ETML-ES-SLO/PRJ_2225_VumetreFrequentiel/2225_B/doc/datasheets/50_Connectors/jack/CUI_DEVICES_SJ1-3533NG/BOM.txt

3DX_CUI_DEVICES_Supplier: CUI Devices
3DX_CUI_DEVICES_Description: 3.5 mm Right-Angle Stereo Jack, 3 Pin PCB Mount, Isolated Ground
3DX_CUI_DEVICES_Model Number: SJ1-3533NG
