ETML-ES-SLO/PRJ_2225_VumetreFrequentiel/2225_B/doc/liens utiles/liens utiles.docx

# USB-C

https://www.act-connectivity.com/fr-fr/usb-c-expliqu%C3%A9#:~:text=Power%20Delivery%20et%20l'USB,%2C%2012V%2C%2015V%20et%2020V.

https://fr.wikipedia.org/wiki/USB_Type-C#:~:text=Depuis%202021%2C%20la%20sp%C3%A9cification%20USB,des%20broches%20CC%20reste%20disponible.

USB-C - Wikipedia (https://en.wikipedia.org/wiki/USB-C)
