ETML-ES-SLO/PRJ_2225_VumetreFrequentiel/2225_B/doc/recherche composant/recherche composants.docx

# Alimentation découplage 5V-3V3

173950336 Würth Elektronik | Alimentations à montage sur carte | DigiKey (https://www.digikey.ch/fr/products/detail/w%C3%BCrth-elektronik/173950336/10468276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)
