ETML-ES-SLO/PRJ_2225_VumetreFrequentiel/2225_B/doc/documents rendu/2225B_VumetreFrequentiel_Code_Gest_LED_C.pdf

/* ************************************************************************** */ /** Descriptive File Name

@Company
Company Name

@File Name
filename.c

@Summary
Brief description of the file.

@Description
Describe the purpose of this file.
*/
/* ************************************************************************** */

/* ************************************************************************** */ /* ************************************************************************** */
/* Section: Included Files | */
/* ************************************************************************** */ /* ************************************************************************** */

/* This section lists the other files that are included in this file.
*/

/* TODO: Include other files here if needed. */
#include <stddef.h> | // Defines NULL

#include <stdbool.h> | // Defines true

#include <stdlib.h> | // Defines EXIT_FAILURE

#include "app.h"

#include "Gest_LED.h"

/* ************************************************************************** */ /* ************************************************************************** */
/* Section: File Scope or Global Data | */
/* ************************************************************************** */ /* ************************************************************************** */

/* A brief description of a section can be given directly below the section banner.
*/

//fonction :Gest_LED
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
void All_LED_Off (void)

11.1 of 13 | 2024.09.24 08:22:50

LED0_ROff();
LED0_GOff();
LED0_YOff();

LED1_ROff();
LED1_GOff();
LED1_YOff();

LED2_ROff();
LED2_GOff();
LED2_YOff();

LED3_ROff();
LED3_GOff();
LED3_YOff();

LED4_ROff();
LED4_GOff();
LED4_YOff();

LED5_ROff();
LED5_GOff();
LED5_YOff();

LED6_ROff();
LED6_GOff();
LED6_YOff();

LED7_ROff();
LED7_GOff();
LED7_YOff();

LED8_ROff();
LED8_GOff();
LED8_YOff();

LED9_ROff();
LED9_GOff();
LED9_YOff();
}
/* ************************************************************************** */ /* ************************************************************************** */
// Section: Interface Functions | */
/* ************************************************************************** */ /* ************************************************************************** */

/* A brief description of a section can be given directly below the section banner.
*/

// *****************************************************************************

12.1 of 13 | 2024.09.24 08:22:50

/**
@Function
int ExampleInterfaceFunctionName ( int param1, int param2 )

@Summary
Brief one-line description of the function.

@Remarks
Refer to the example_file.h interface header for function usage details. */
int ExampleInterfaceFunction(int param1, int param2) {
return 0;
}

/* ***************************************************************************** End of File
*/
13.1 of 13 | 2024.09.24 08:22:50
