ETML-ES-SLO/PRJ_2225_VumetreFrequentiel/2225_B/doc/documents rendu/2225B_VumetreFrequentiel_Code_dac_ad5620_h.pdf

#ifndef dac_ad5620_H

#define dac_ad5620_H

/*--------------------------------------------------------*/ // dac_ad5620_H.h
/*--------------------------------------------------------*/ //Description :Utiilisation DAC AD5620
//
//Auteur : LDD
//Version:V1.0
//Compilateur:XC32 V2.50
//
/*--------------------------------------------------------*/

#include <stdint.h>

// prototypes des fonctions void Dac_Init(void);
void Dac_Write( uint16_t ech); void spi_write( uint8_t Val);

#endif // dac_ad5620_H

C:/microchip/harmony/v2_06/apps/2225_VumetreFrequenciel/firmware/src/dac_ad5620.h

1.1 of 1 | 2023.06.19 14:35:32
