ETML-ES-SLO/PRJ_2225_VumetreFrequentiel/2225_B/doc/datasheets/40_LEDs/Résutat led.PNG

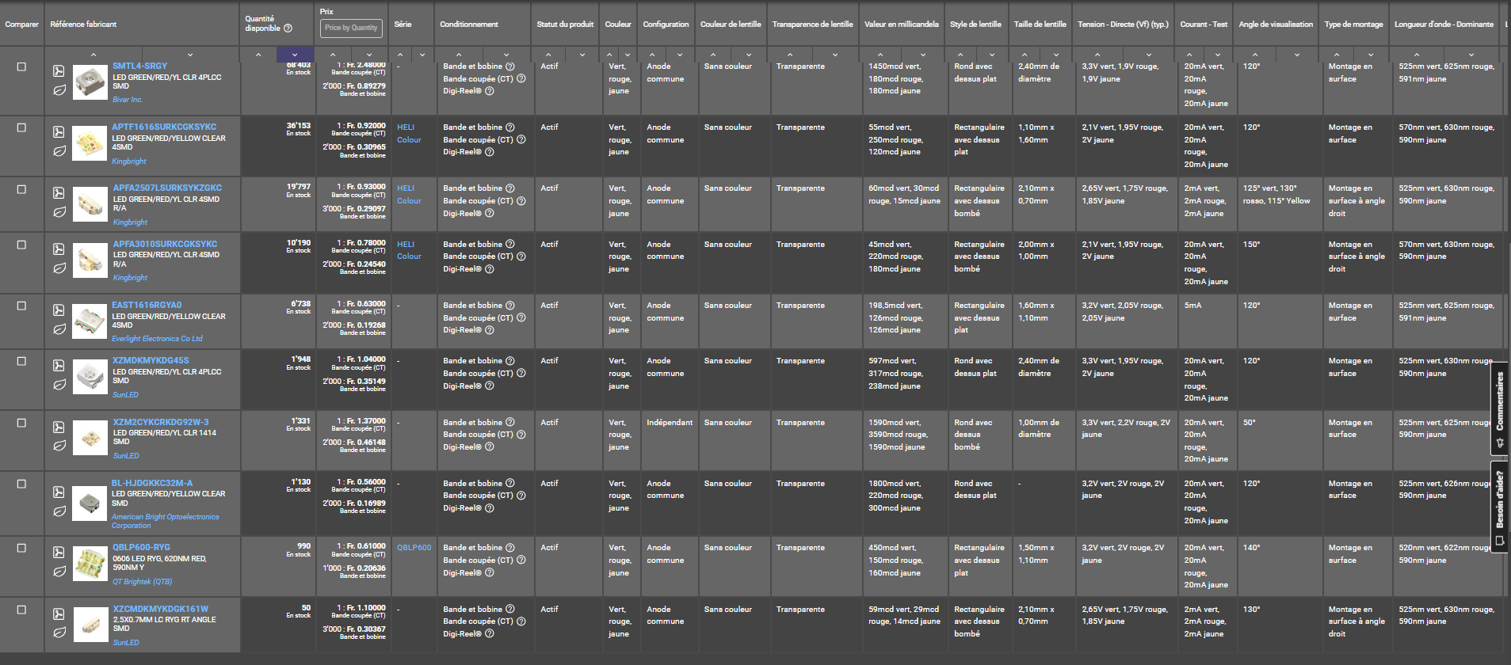
2225_B/doc/datasheets/40_LEDs/Résutat led.PNG
