ETML-ES-SLO/PRJ_2225_VumetreFrequentiel/2225_B/doc/immages rapport/173950336.jpg

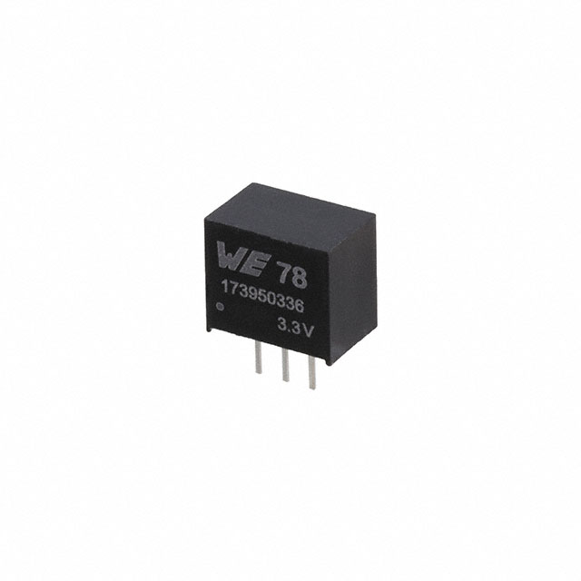
2225_B/doc/immages rapport/173950336.jpg
