ETML-ES-SLO/PRJ_2225_VumetreFrequentiel/2225_B/doc/screeen/adc config armony 2.PNG

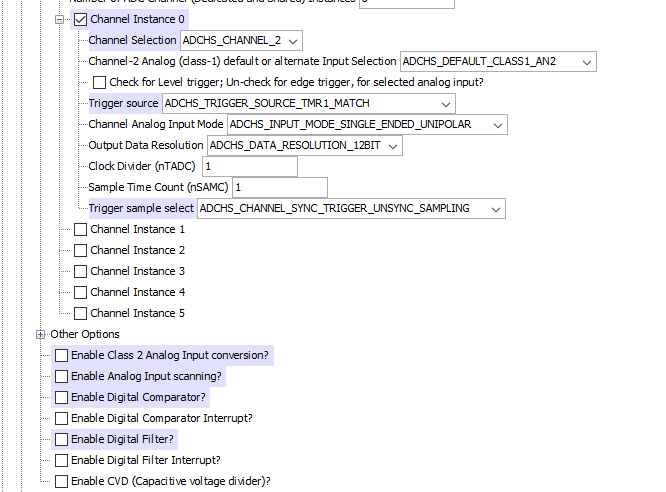
2225_B/doc/screeen/adc config armony 2.PNG
