ETML-ES-SLO/PRJ_2225_VumetreFrequentiel/2225_B/doc/screeen/CH1usbCH1usbCH3RXD FTDI.BMP

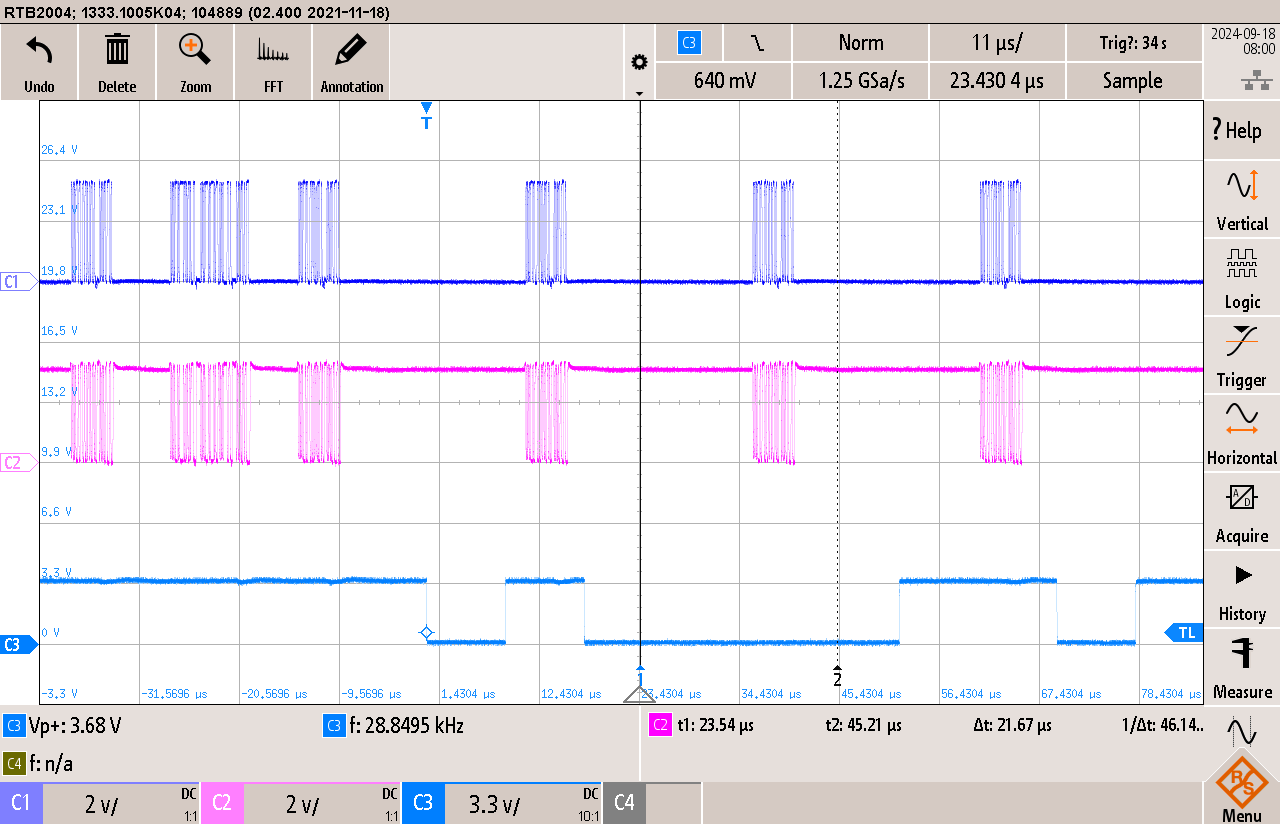
2225_B/doc/screeen/CH1usbCH1usbCH3RXD FTDI.BMP
