ETML-ES-SLO/PRJ_2225_VumetreFrequentiel/2225_B/doc/screeen/fréquence pour timers.PNG

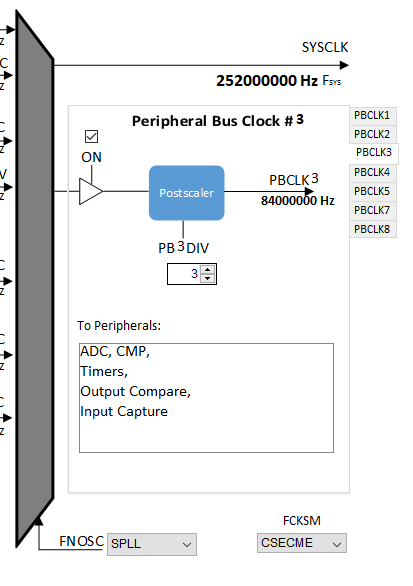
2225_B/doc/screeen/fréquence pour timers.PNG
