ETML-ES-SLO/PRJ_2225_VumetreFrequentiel/2225_B/doc/screeen/FTDI whith uc.PNG

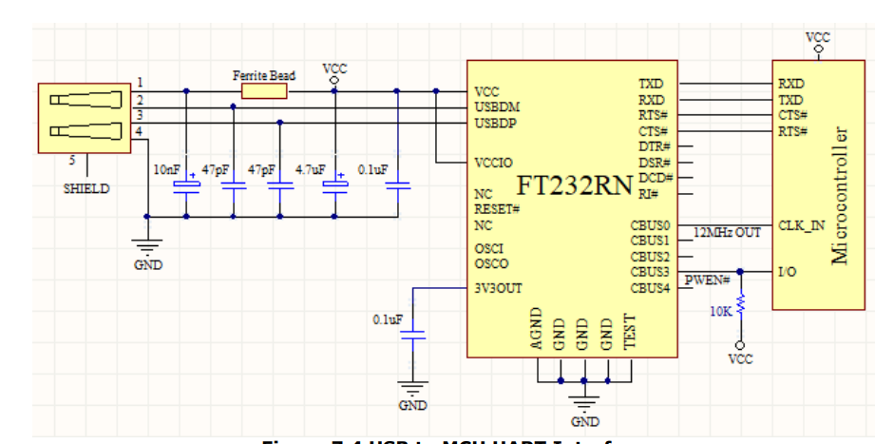
2225_B/doc/screeen/FTDI whith uc.PNG
