ETML-ES-SLO/PRJ_2225_VumetreFrequentiel/2225_B/doc/screeen/MESURE_DAC1V.BMP

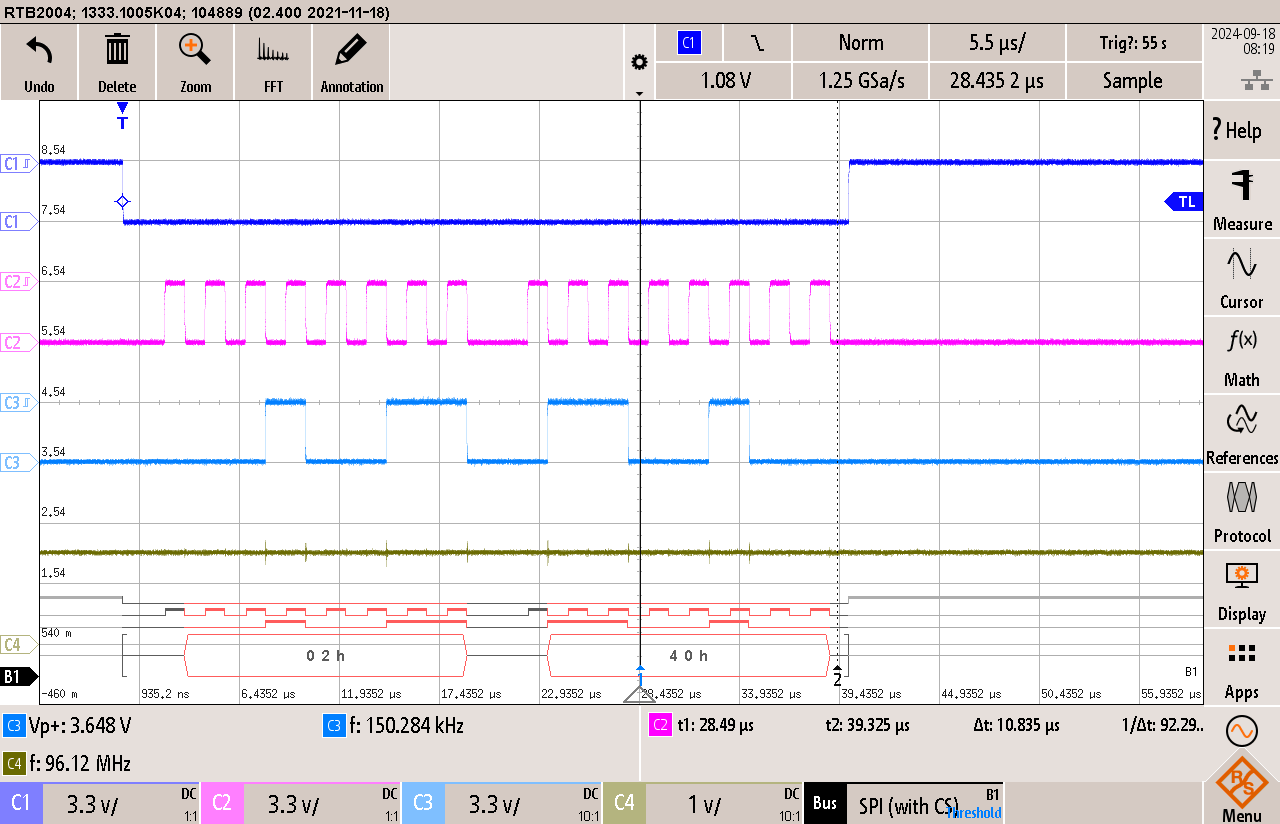
2225_B/doc/screeen/MESURE_DAC1V.BMP
