ETML-ES-SLO/PRJ_2225_VumetreFrequentiel/2225_B/doc/screeen/timer init armony.PNG

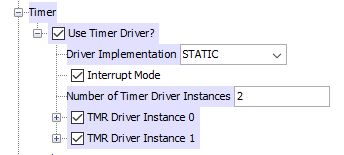
2225_B/doc/screeen/timer init armony.PNG
