ETML-ES-SLO/PRJ_2225_VumetreFrequentiel/2225_A/hard/BOM.xlsx

Désignation | Type | Nom | Lien internet | Quantité | Prix | Possédé?
 | Ampli-OP | MCP6002T-I/SN | https://www.digikey.ch/fr/products/detail/microchip-technology/MCP6002T-I-SN/500878 | 1 | 0.4 |  | Nombre composants | 17
 | Connecteur Jack 3.5mm | SJ-3523-SMT-TR | https://www.digikey.ch/fr/products/detail/cui-devices/SJ-3523-SMT-TR/281297 | 2 | 0.94 |  | Total: | 35.85
 | Connecteur Jack 6.35mm | SN37A12A | https://www.digikey.ch/fr/products/detail/switchcraft-inc/SN37A12A/1288899 | 2 | 3.63
 | Connecteur BNC | CONBNC002 | https://www.digikey.ch/fr/products/detail/linx-technologies-inc/CONBNC002/16013841 | 2 | 2.87
 | Connecteur programmation | 76384-406LF | https://www.digikey.ch/fr/products/detail/amphenol-cs-fci/76384-406LF/1001635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 | 1 | 0.82 | X
 | Connecteur alimentation | RASM722PTR13X |  | 1 | 2.31 | X
 | Quartz 10MHz | ATS100SM-1 | https://www.digikey.ch/fr/products/detail/cts-frequency-controls/ATS100SM-1/280226 | 1 | 0.34
 | Bouton poussoir | 430182043816 | https://www.digikey.ch/fr/products/detail/w%C3%BCrth-elektronik/430182043816/5209017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 | 1 | 0.49 | X
 | Regulateur 5V-3V3 | MAX1793EUE33+ | https://www.digikey.ch/fr/products/detail/analog-devices-inc-maxim-integrated/MAX1793EUE33/1513120 | 1 | 4.06 | X
 | Led témoin alimentation | LTST-C191KFKT | https://www.digikey.ch/fr/products/detail/liteon/LTST-C191KFKT/386833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 | 2 | 0.22 | X
 | Connecteur matrice à Leds | 61030821821 | https://www.digikey.ch/fr/products/detail/w%C3%BCrth-elektronik/61030821821/9857504 | 1 | 1.68
 | Microcontrôleur | PIC32MX470F512H-120/PT | https://www.digikey.ch/fr/products/detail/microchip-technology/PIC32MX470F512H-120-PT/5305173 | 1 | 9.83 | X
 | Référence de tension | TL431LIBQDBZRQ1 | https://www.digikey.ch/fr/products/detail/texas-instruments/TL431LIBQDBZRQ1/11308815 | 1 | 0.6
