ETML-ES-SLO/PRJ_2225_VumetreFrequentiel/2225_B/doc/estimation des couts/Estimation des couts.xlsx

Exstimation prix composants interne
Composant | quantité | prix unité [CHF] | Prix (aproximatif) [CHF]
régulateurs | 3 | 5 | 15
Module Xbee | 2 | 20 | 40
micro | 2 | 5 | 10
PCB | 2 | 60 | 120
Composants divers | 20 | 1 | 20
TOTAL |  |  | 205
