ETML-ES-SLO/PRJ_2225_VumetreFrequentiel/2225_A/hard/Footprints et symboles/IC_Microchip_PIC32MX470F512H-120_PT/parts/IC_Microchip_PIC32MX470F512H-120-PT_eec.STEP

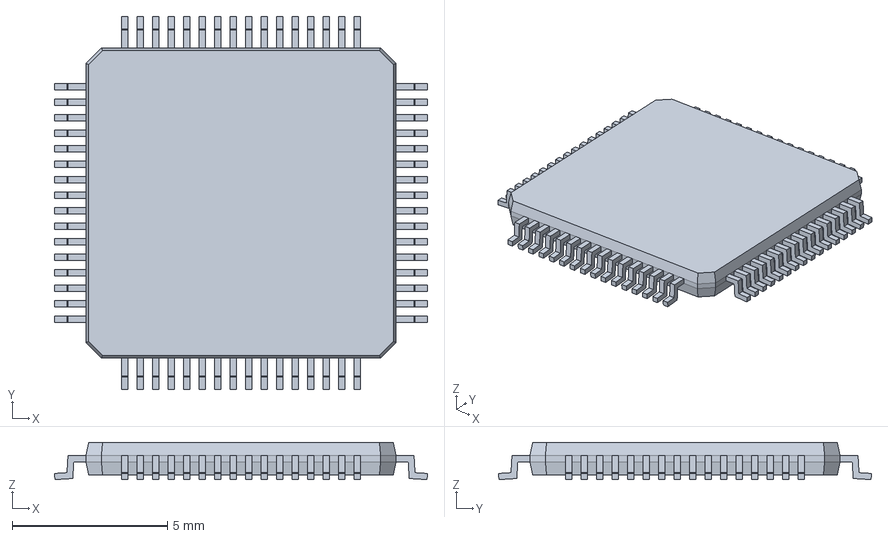
[picture p94: CAD file, 2024-09-24]
2225_A/hard/Footprints et symboles/IC_Microchip_PIC32MX470F512H-120_PT/parts/IC_Microchip_PIC32MX470F512H-120-PT_eec.STEP
12.0 x 12.0 x 1.20 mm
