ETML-ES-SLO/PRJ_2225_VumetreFrequentiel/2225_A/hard/Footprints et symboles/ul_MAX1793EUE33-/AltiumDesigner/2023-01-25_09-02-42/21-0108_U16E+3_MXM.step

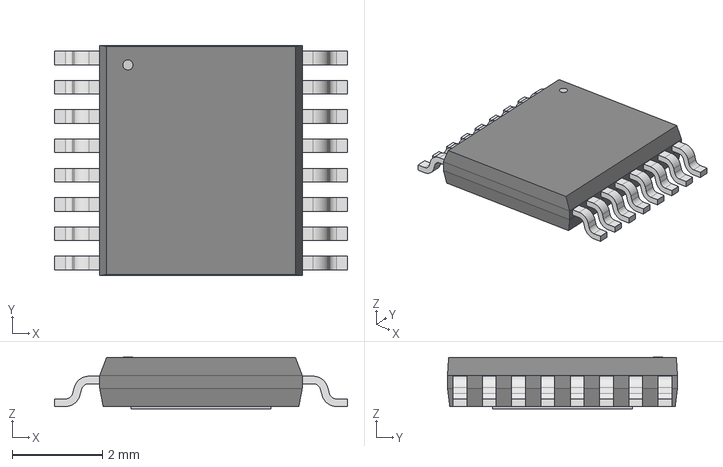
[picture p95: CAD file, 2024-09-24]
2225_A/hard/Footprints et symboles/ul_MAX1793EUE33-/AltiumDesigner/2023-01-25_09-02-42/21-0108_U16E+3_MXM.step
6.50 x 5.11 x 1.15 mm
