ETML-ES-SLO/PRJ_2225_VumetreFrequentiel/2225_A/hard/Footprints et symboles/ul_MCP6002T-I-SN/AltiumDesigner/2023-01-11_14-45-16/SOIC8-N_MC_MCH.step

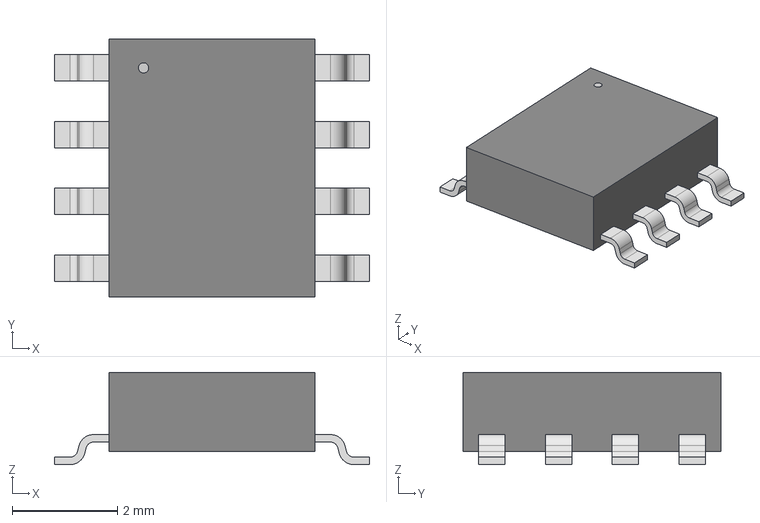
[picture p96: CAD file, 2024-09-24]
2225_A/hard/Footprints et symboles/ul_MCP6002T-I-SN/AltiumDesigner/2023-01-11_14-45-16/SOIC8-N_MC_MCH.step
5.99 x 4.90 x 1.75 mm
