ETML-ES-SLO/PRJ_2225_VumetreFrequentiel/2225_B/doc/datasheets/01_uc/PIC32MZ2048EFH064-250I_PT.STEP

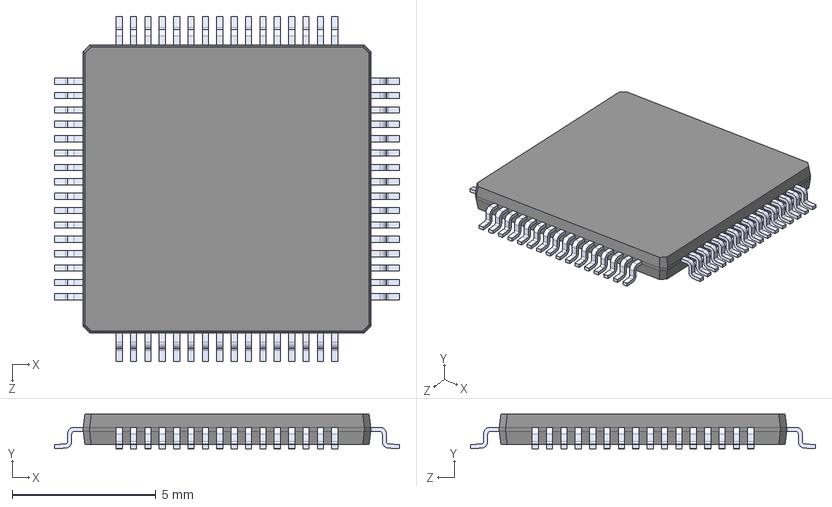
[picture p97: CAD file, 2024-09-24]
2225_B/doc/datasheets/01_uc/PIC32MZ2048EFH064-250I_PT.STEP
12.0 x 1.20 x 12.0 mm
