ETML-ES-SLO/PRJ_2225_VumetreFrequentiel/2225_B/doc/datasheets/10_dc-dc converter/STP_173950336_rev1.stp

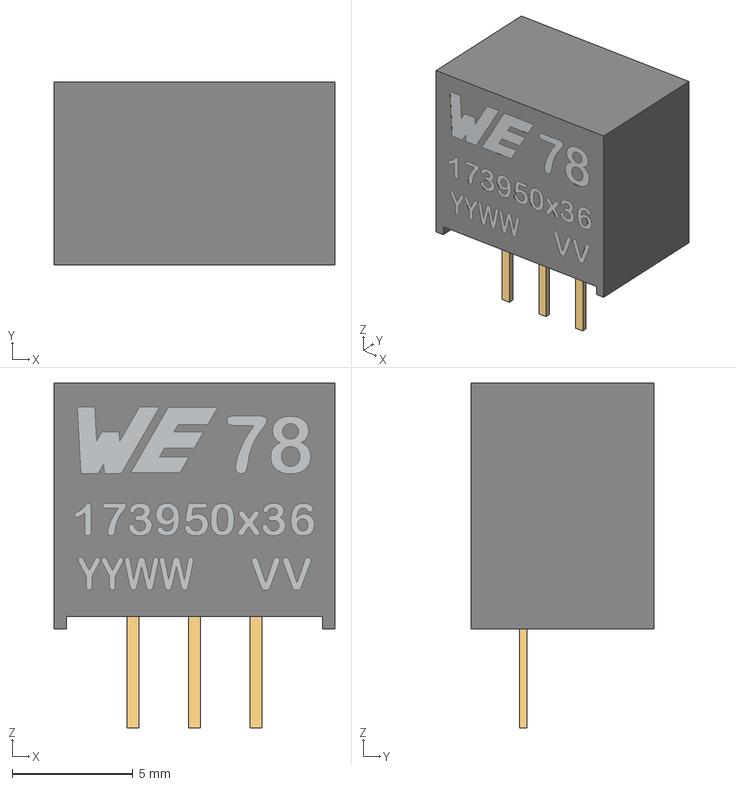
[picture p98: CAD file, 2024-09-24]
2225_B/doc/datasheets/10_dc-dc converter/STP_173950336_rev1.stp
11.6 x 7.55 x 14.3 mm
