ETML-ES-SLO/PRJ_2225_VumetreFrequentiel/2225_B/doc/datasheets/40_LEDs/LIB_APTF1616SURKCGKSYKC/APTF1616SURKCGKSYKC/3D/APTF1616SURKCGKSYKC.stp

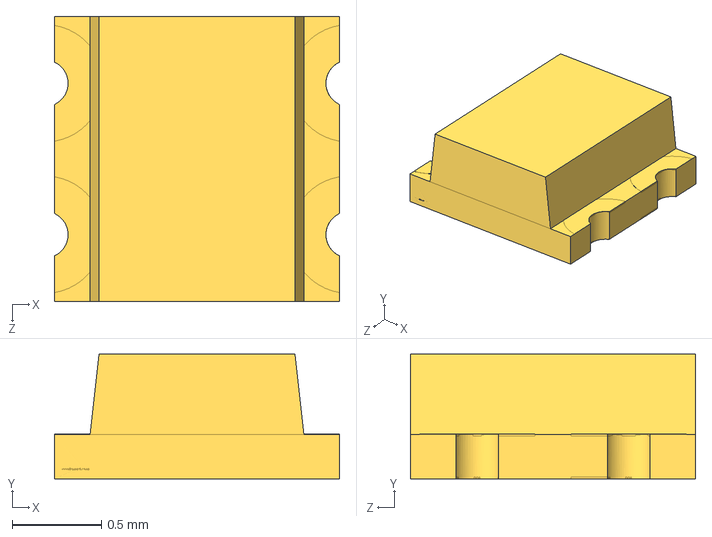
[picture p99: CAD file, 2024-09-24]
2225_B/doc/datasheets/40_LEDs/LIB_APTF1616SURKCGKSYKC/APTF1616SURKCGKSYKC/3D/APTF1616SURKCGKSYKC.stp
1.60 x 0.7 x 1.60 mm
