ETML-ES-SLO/PRJ_2225_VumetreFrequentiel/2225_B/doc/datasheets/41_Cap_Pol/4.7u/10SVP4R7M/4 SIZE CODE A5.stp

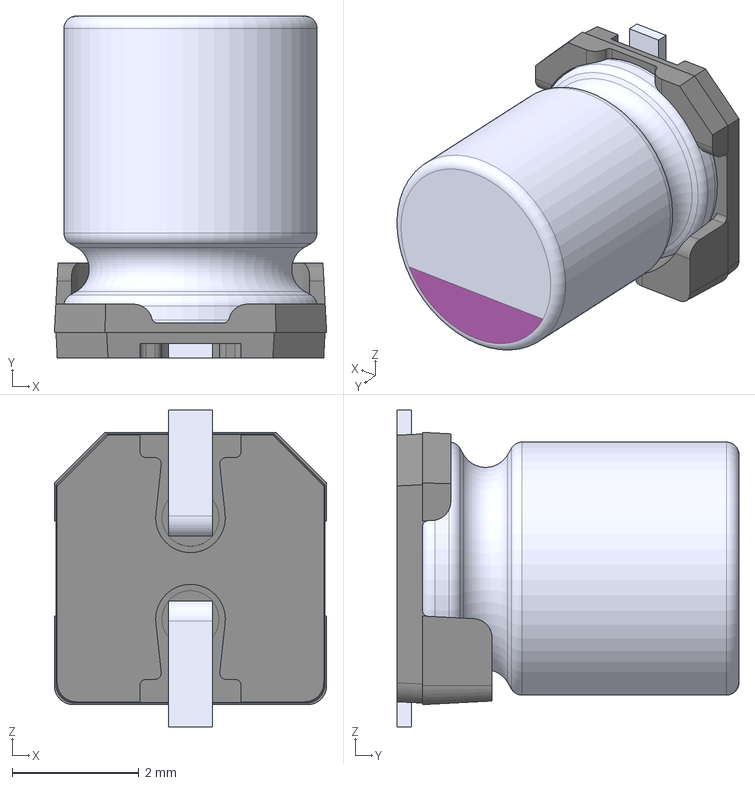
[picture p100: CAD file, 2024-09-24]
2225_B/doc/datasheets/41_Cap_Pol/4.7u/10SVP4R7M/4 SIZE CODE A5.stp
4.30 x 5.40 x 5.00 mm
