ETML-ES-SLO/PRJ_2225_VumetreFrequentiel/2225_B/doc/datasheets/41_Cap_Pol/4.7u/10SVP4R7M/AltiumDesigner/PCAP_SVP_A5_PAN.step

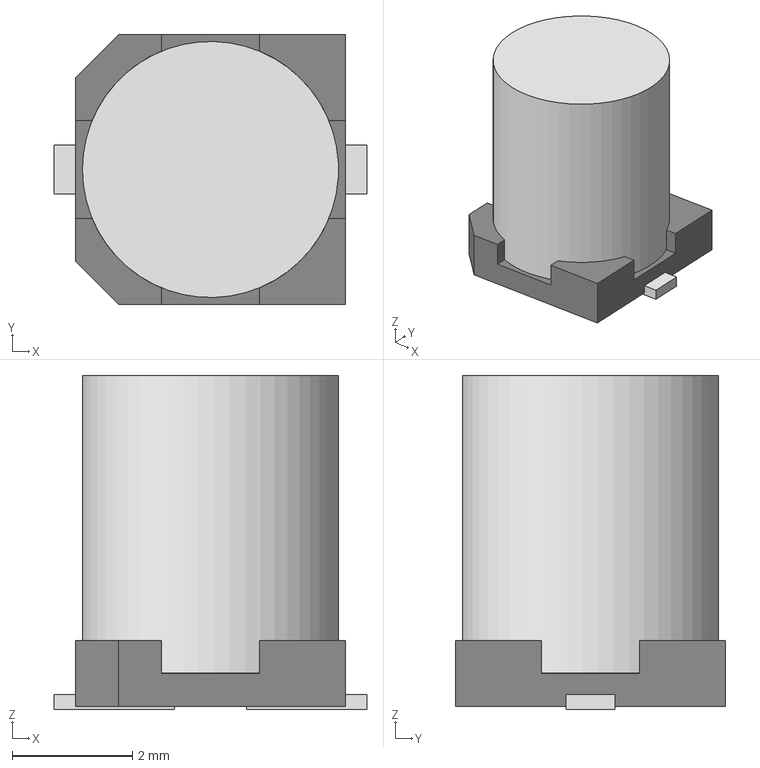
[picture p101: CAD file, 2024-09-24]
2225_B/doc/datasheets/41_Cap_Pol/4.7u/10SVP4R7M/AltiumDesigner/PCAP_SVP_A5_PAN.step
5.21 x 4.50 x 5.57 mm
