ETML-ES-SLO/PRJ_2225_VumetreFrequentiel/2225_B/doc/datasheets/50_Connectors/jack/CUI_DEVICES_SJ1-3533NG/CUI_DEVICES_SJ1-3533NG.step

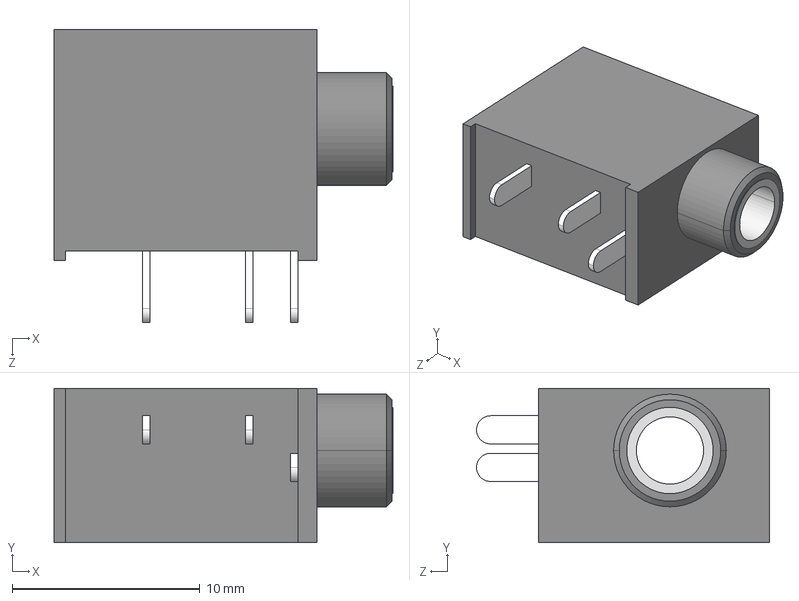
[picture p102: CAD file, 2024-09-24]
2225_B/doc/datasheets/50_Connectors/jack/CUI_DEVICES_SJ1-3533NG/CUI_DEVICES_SJ1-3533NG.step
18.1 x 8.20 x 15.6 mm
