ETML-ES-SLO/PRJ_2225_VumetreFrequentiel/2225_B/doc/datasheets/50_Connectors/USB-C/USB4085-GF-A--3DModel-STEP-56544.STEP

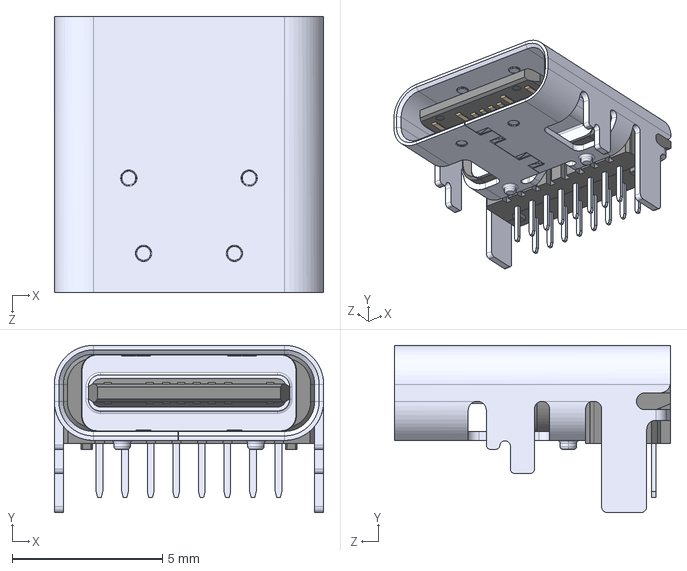
[picture p103: CAD file, 2024-09-24]
2225_B/doc/datasheets/50_Connectors/USB-C/USB4085-GF-A--3DModel-STEP-56544.STEP
8.95 x 5.56 x 9.17 mm
