ETML-ES-SLO/PRJ_2225_VumetreFrequentiel/2225_B/doc/datasheets/50_Connectors/USB-COM/USB-A1HSW6--3DModel-STEP-56544.STEP

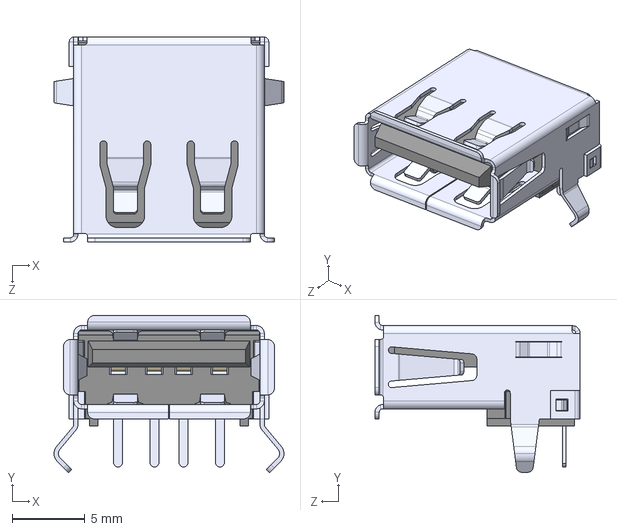
[picture p104: CAD file, 2024-09-24]
2225_B/doc/datasheets/50_Connectors/USB-COM/USB-A1HSW6--3DModel-STEP-56544.STEP
15.8 x 10.8 x 14.1 mm
