ETML-ES-SLO/PRJ_2225_VumetreFrequentiel/2225_B/doc/datasheets/60_FTDI/LIB_FT232RNL-REEL/FT232RNL-REEL/3D/FT232RNL-REEL.stp

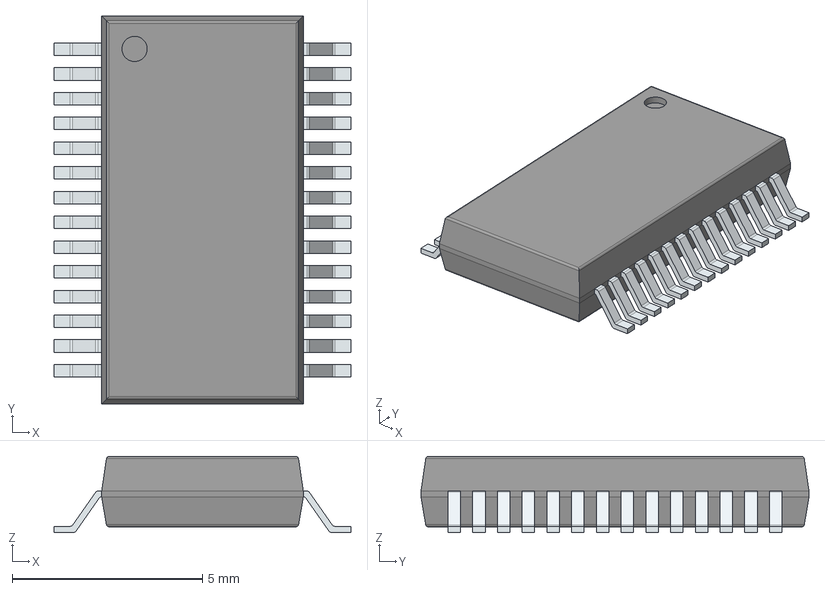
[picture p105: CAD file, 2024-09-24]
2225_B/doc/datasheets/60_FTDI/LIB_FT232RNL-REEL/FT232RNL-REEL/3D/FT232RNL-REEL.stp
7.80 x 10.2 x 2.00 mm
PinsArrayLR
