ETML-ES-SLO/PRJ_2225_VumetreFrequentiel/2225_B/doc/datasheets/90_IO_Expender/LIB_TCA9536DGKR/TCA9536DGKR/3D/TCA9536DGKR.stp

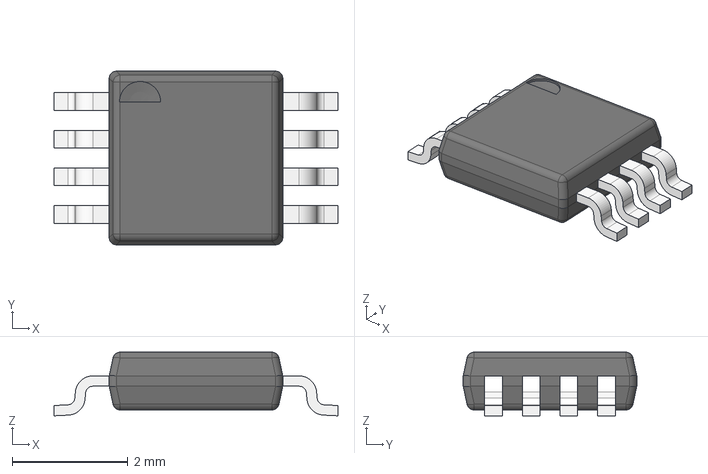
[picture p106: CAD file, 2024-09-24]
2225_B/doc/datasheets/90_IO_Expender/LIB_TCA9536DGKR/TCA9536DGKR/3D/TCA9536DGKR.stp
4.90 x 3.00 x 1.10 mm
BODY_MUA08A
LEAD_MUA08A x 8
