ETML-ES-SLO/PRJ_2225_VumetreFrequentiel/2225_B/doc/datasheets/50_Connectors/port_prog/61300611121_Download_STP_61300611121_rev1.stp

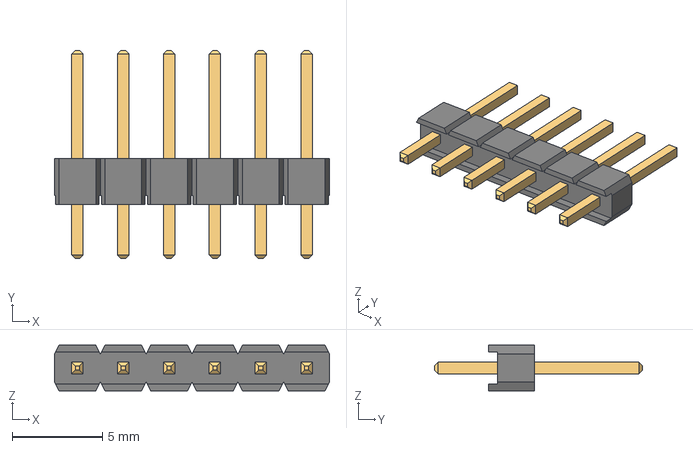
[picture p107: CAD file, 2024-09-24]
2225_B/doc/datasheets/50_Connectors/port_prog/61300611121_Download_STP_61300611121_rev1.stp
15.2 x 11.5 x 2.54 mm
6130xx11121_PIN x 6
