ETML-ES-SLO/PRJ_2225_VumetreFrequentiel/(list of files, cad)

Other CAD files:
2225_B/doc/datasheets/90_IO_Expender/LIB_TCA9536DGKR/TCA9536DGKR/Allegro/sop65p490x110-8n.psm
2225_B/doc/datasheets/90_IO_Expender/LIB_TCA9536DGKR/TCA9536DGKR/DEHDL/tca9536dgkr/chips/chips.prt
