ETML-ES-SLO/PRJ_2225_VumetreFrequentiel/2225_B/doc/planification + journal de travail/Planification.xlsx

Sheet: planification
No Jour travail |  | 1 | 2 | 3 | 4 | 5 | 6 | 7 | 8 | 9 | 10 | 11 | 12 | 13 | 14 | 15 | 16 | 17 | 18 | 19 | 20 | 21 | 22 | 23 | 24 | 25
Date |  | 2024-08-19 | 2024-08-20 | 2024-08-21 | 2024-08-22 | 2024-08-23 | 2024-08-26 | 2024-08-27 | 2024-08-28 | 2024-08-29 | 2024-08-30 | 2024-09-02 | 2024-09-03 | 2024-09-04 | 2024-09-05 | 2024-09-06 | 2024-09-09 | 2024-09-10 | 2024-09-11 | 2024-09-12 | 2024-09-13 | 2024-09-17 | 2024-09-18 | 2024-09-19 | 2024-09-20 | 2024-09-23
Tâches
lecture cahier des charge et premier et premier schéma block | théorique
 | rééle
étude et choix composants | théorique
 | rééle
réalisation du schéma | théorique
 | rééle
rechercher et réalisation footprints | théorique
 | rééle
réalisation du design | théorique
 | rééle
Programmation | théorique
 | rééle
Montage carte | théorique
 | rééle
test et validation différents modules | théorique
 | rééle
réalisation du code finale | théorique
 | rééle
Réalisation du programme C# | théorique
 | rééle
rédaction du rapport | théorique
 | rééle
Boîtier impémentation | théorique
 | rééle

Sheet: Journal de travail
Date | Tâches effectuées | Difficultés | solutions et décisions
2024-08-19 | prise connaisance du cahier des charges et compréhension de ce qui est demandé
2024-08-20 | compréhesion des principes de base et début de la recherche des composants
2024-08-21 | commencement du schéma
2024-08-22 | dimentionnement schéma + revue schéma
2024-08-23 | correction du schéma
2024-08-26 | recherche footprints
2024-08-27 | validation des footprints + placement des composants
2024-08-28 | finition du placement des composants + routage | taille du boîtier semble trop grande | pas de boîtier asser long avec une plus petite largeur
2024-08-29 | routage + BOM + revue PCB
2024-08-30 | Correction du PCB + Commande composants
2024-09-02 | Commande PCB | Probleme avec eurocircuit | correction effectuées plusieurs fois
2024-09-03 | Reflexion programme sur les filtres numériques
2024-09-04
2024-09-05 | Vérifiaction commande composants
2024-09-06 | Montage PCB
2024-09-09 | Finition montage PCB + test diffétents module
2024-09-10 | Test LEDS | 4 LEDs ne fontionne pas | refaire brasure LED + mosfet -> plus que 1 LED qui ne fonctionne pas
2024-09-11 | test ADC et DAC | Lecture ADC compliquée | Réussi a faire fonctionner l'ADC
2024-09-12 | recherche librairie filtres numérique | programme principale est ralenti à cause du DAC | faire le filtrage dans l'intéruption du timer
2024-09-13 | Programmation partie lecture échantillonage
2024-09-16 | Prgrammation partie prendre val haut et bas
2024-09-17 | Programmation de la partie offset | Offset incorect | Prbléme lors de la mesure du niveau haut et bas
2024-09-18 | Restructuration du programme | échantillons et calcul en meme temps | le programme doit attendre de faire un certains nombre d'échantillons avant de faire les calculs
2024-09-19 | faire au maximum pour avoir un programme qui aie au moins une lecture de fréquence
2024-09-20 | Rédaction rapport + mesures néscéssaires
2024-09-23 | rédaction du rapport
2024-09-24 | Rendu du rapport 10h00
2024-09-25
2024-09-26
2024-09-27
