ETML-ES-SLO/PRJ_2225_VumetreFrequentiel/2225_B/doc/documents rendu/2225B_VumetreFrequentiel_Schematic_Variant_No Variations.PDF

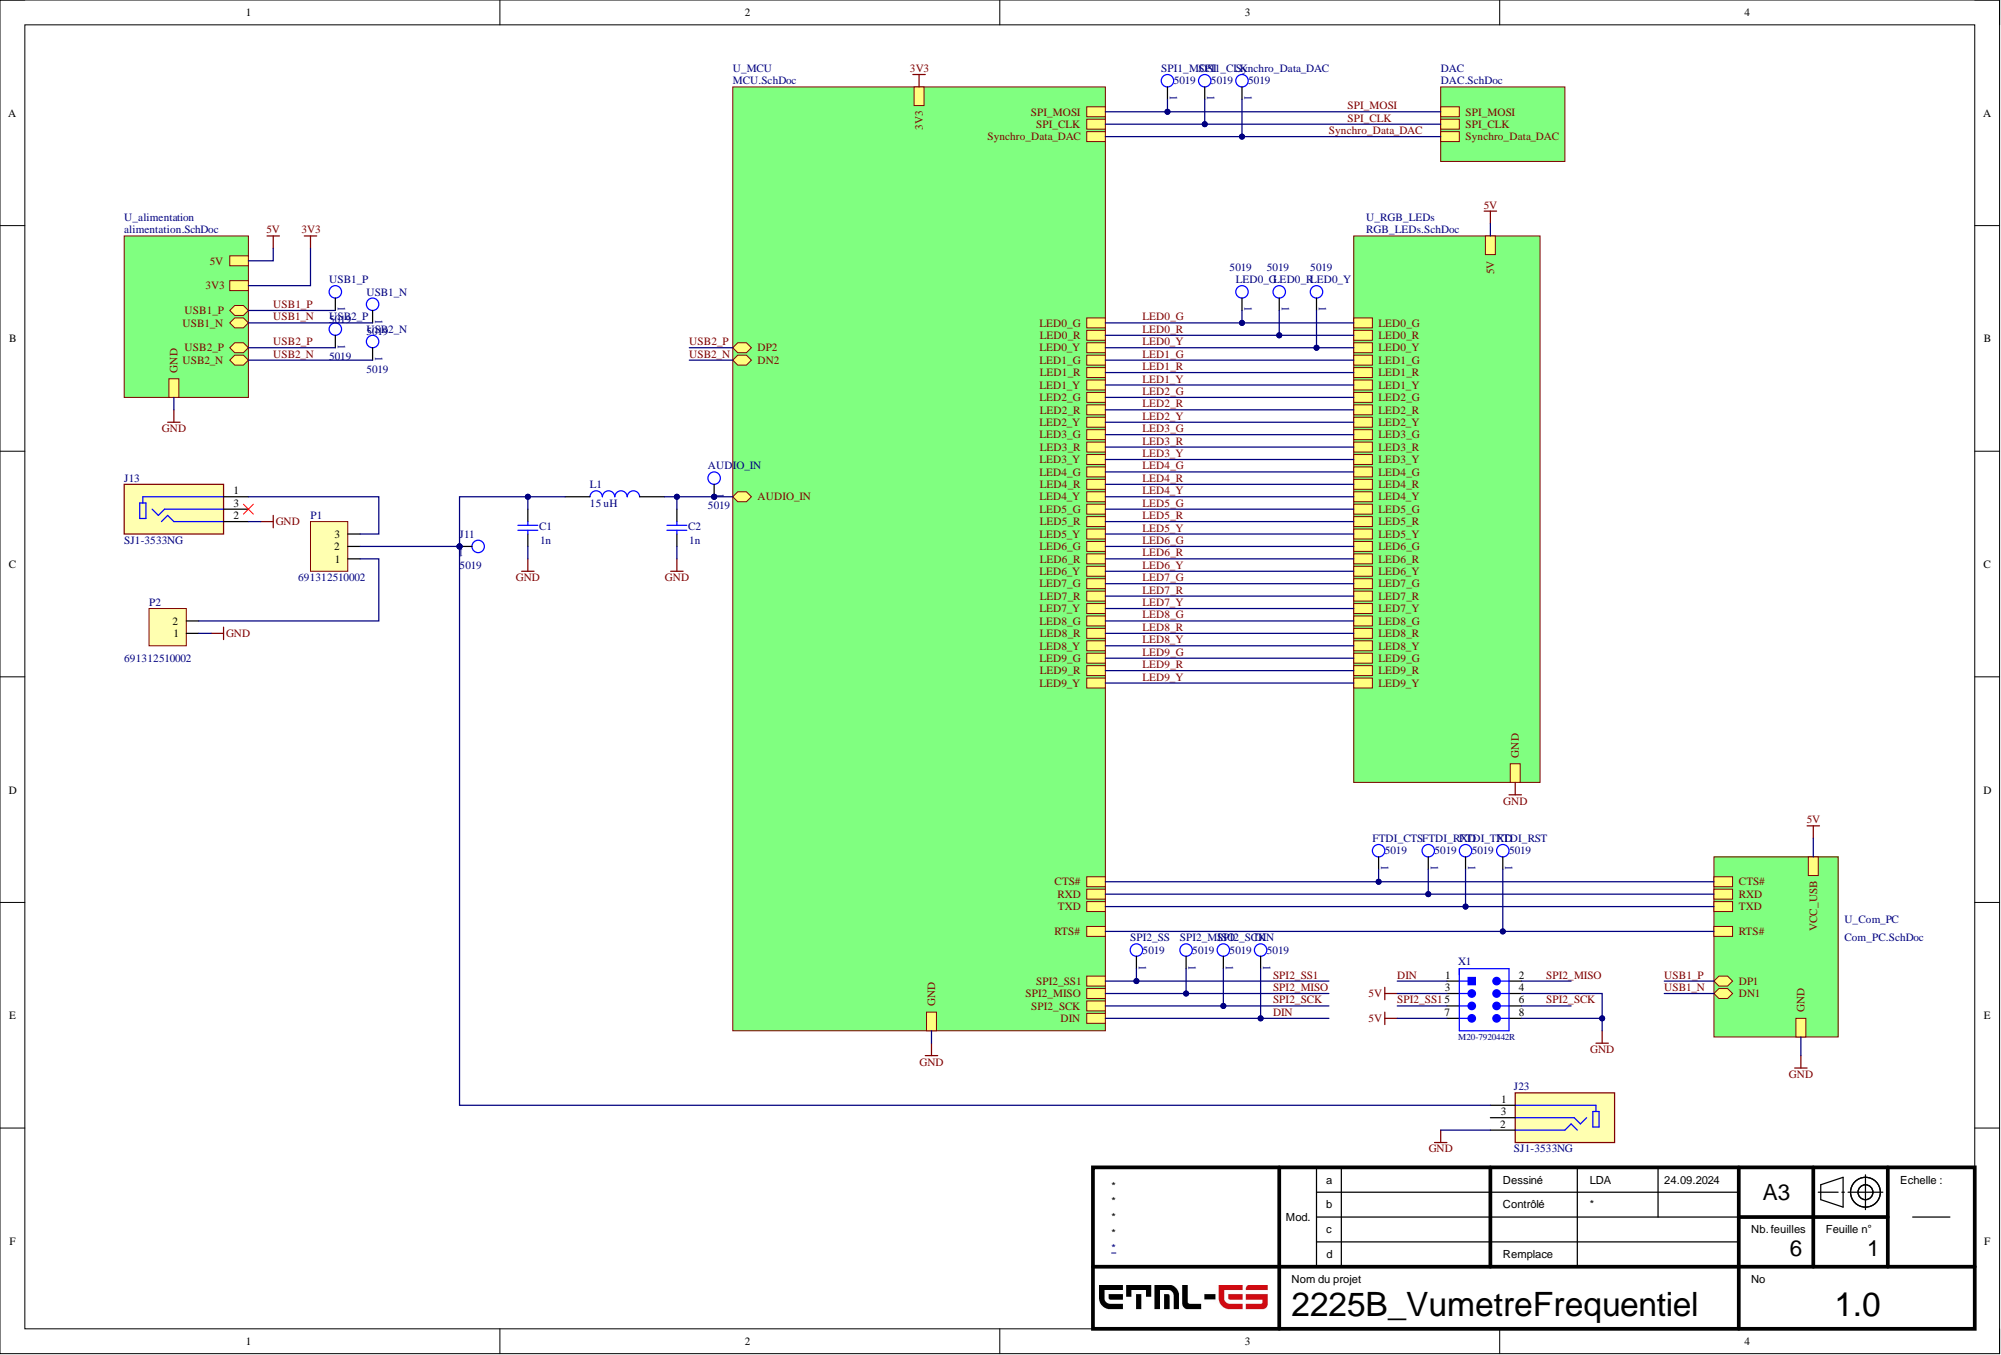
[picture p108: page 1]

SPI_CLK
Synchro_Data_DAC

* * * * * | Mod. | a | Dessiné | LDA | 24.09.2024 | A3 | | Echelle :

b | Contrôlé | *

c | | | | Nb. feuilles 6 | Feuille n° 1

d | Remplace

Nom du projet 2225B_VumetreFrequentiel | | | | | No 1.0

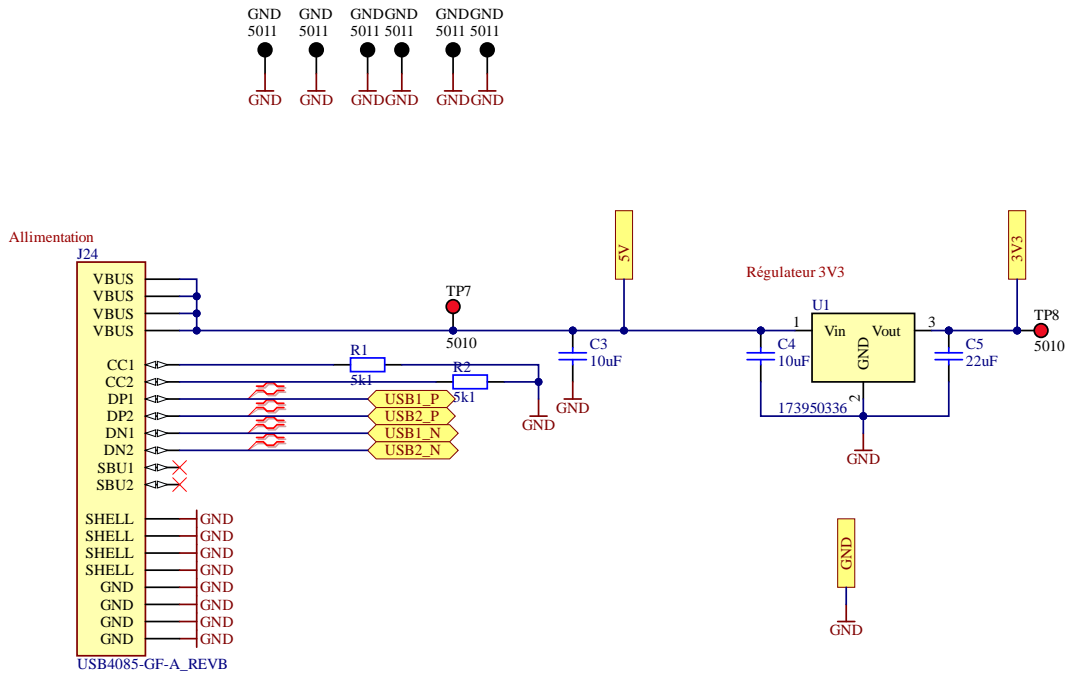
[picture p109: page 2]

* * * * * | Mod. | a | Dessiné | LDA | 24.09.2024 | A4 | | Echelle :

b | Contrôlé | *

c | | | | Nb. feuilles 6 | Feuille n° 2

d | Remplace

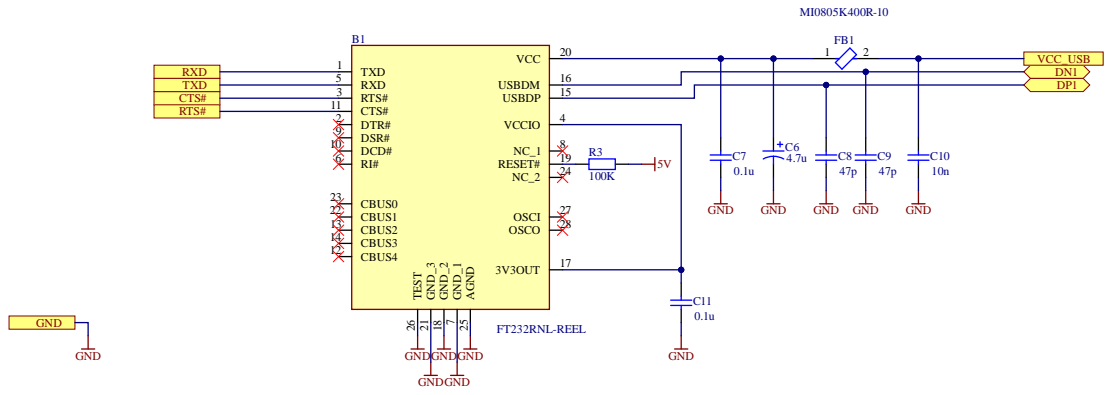
[picture p110: page 3]

3 | 1 5
1 1 | 4

** *** | Mod . | | Des s i n é | LD A | 24.09.20 2 4 | A4 | Echelle :

abcd | Cont r ô l é | *

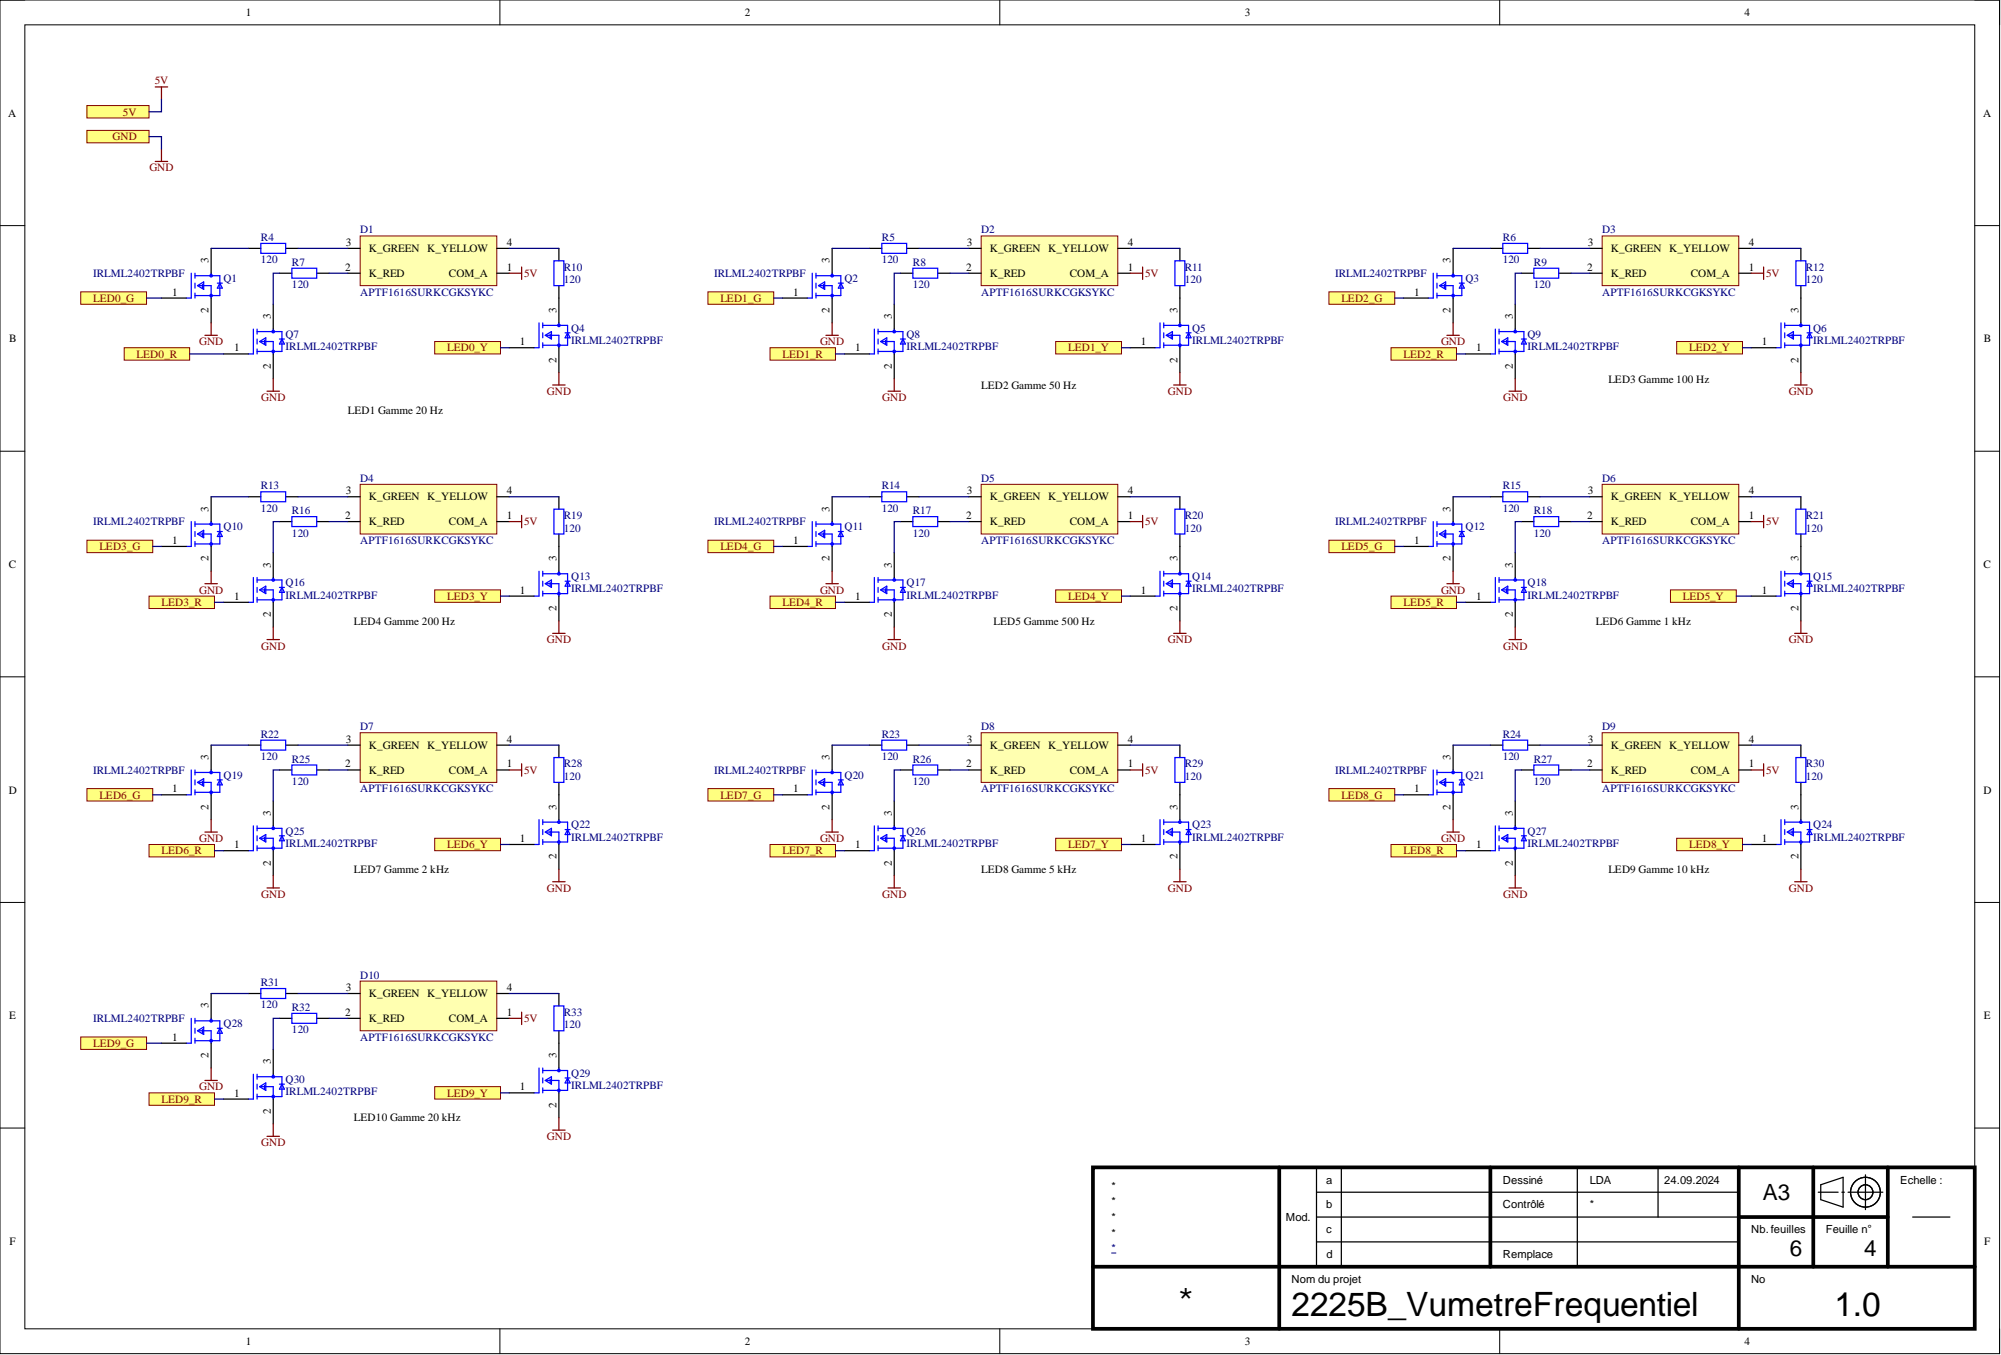
[picture p111: page 4]

* * * * * | Mod. | a | Dessiné | LDA | 24.09.2024 | A3 | | Echelle :

b | Contrôlé | *

c | | | | Nb. feuilles 6 | Feuille n° 4

d | Remplace

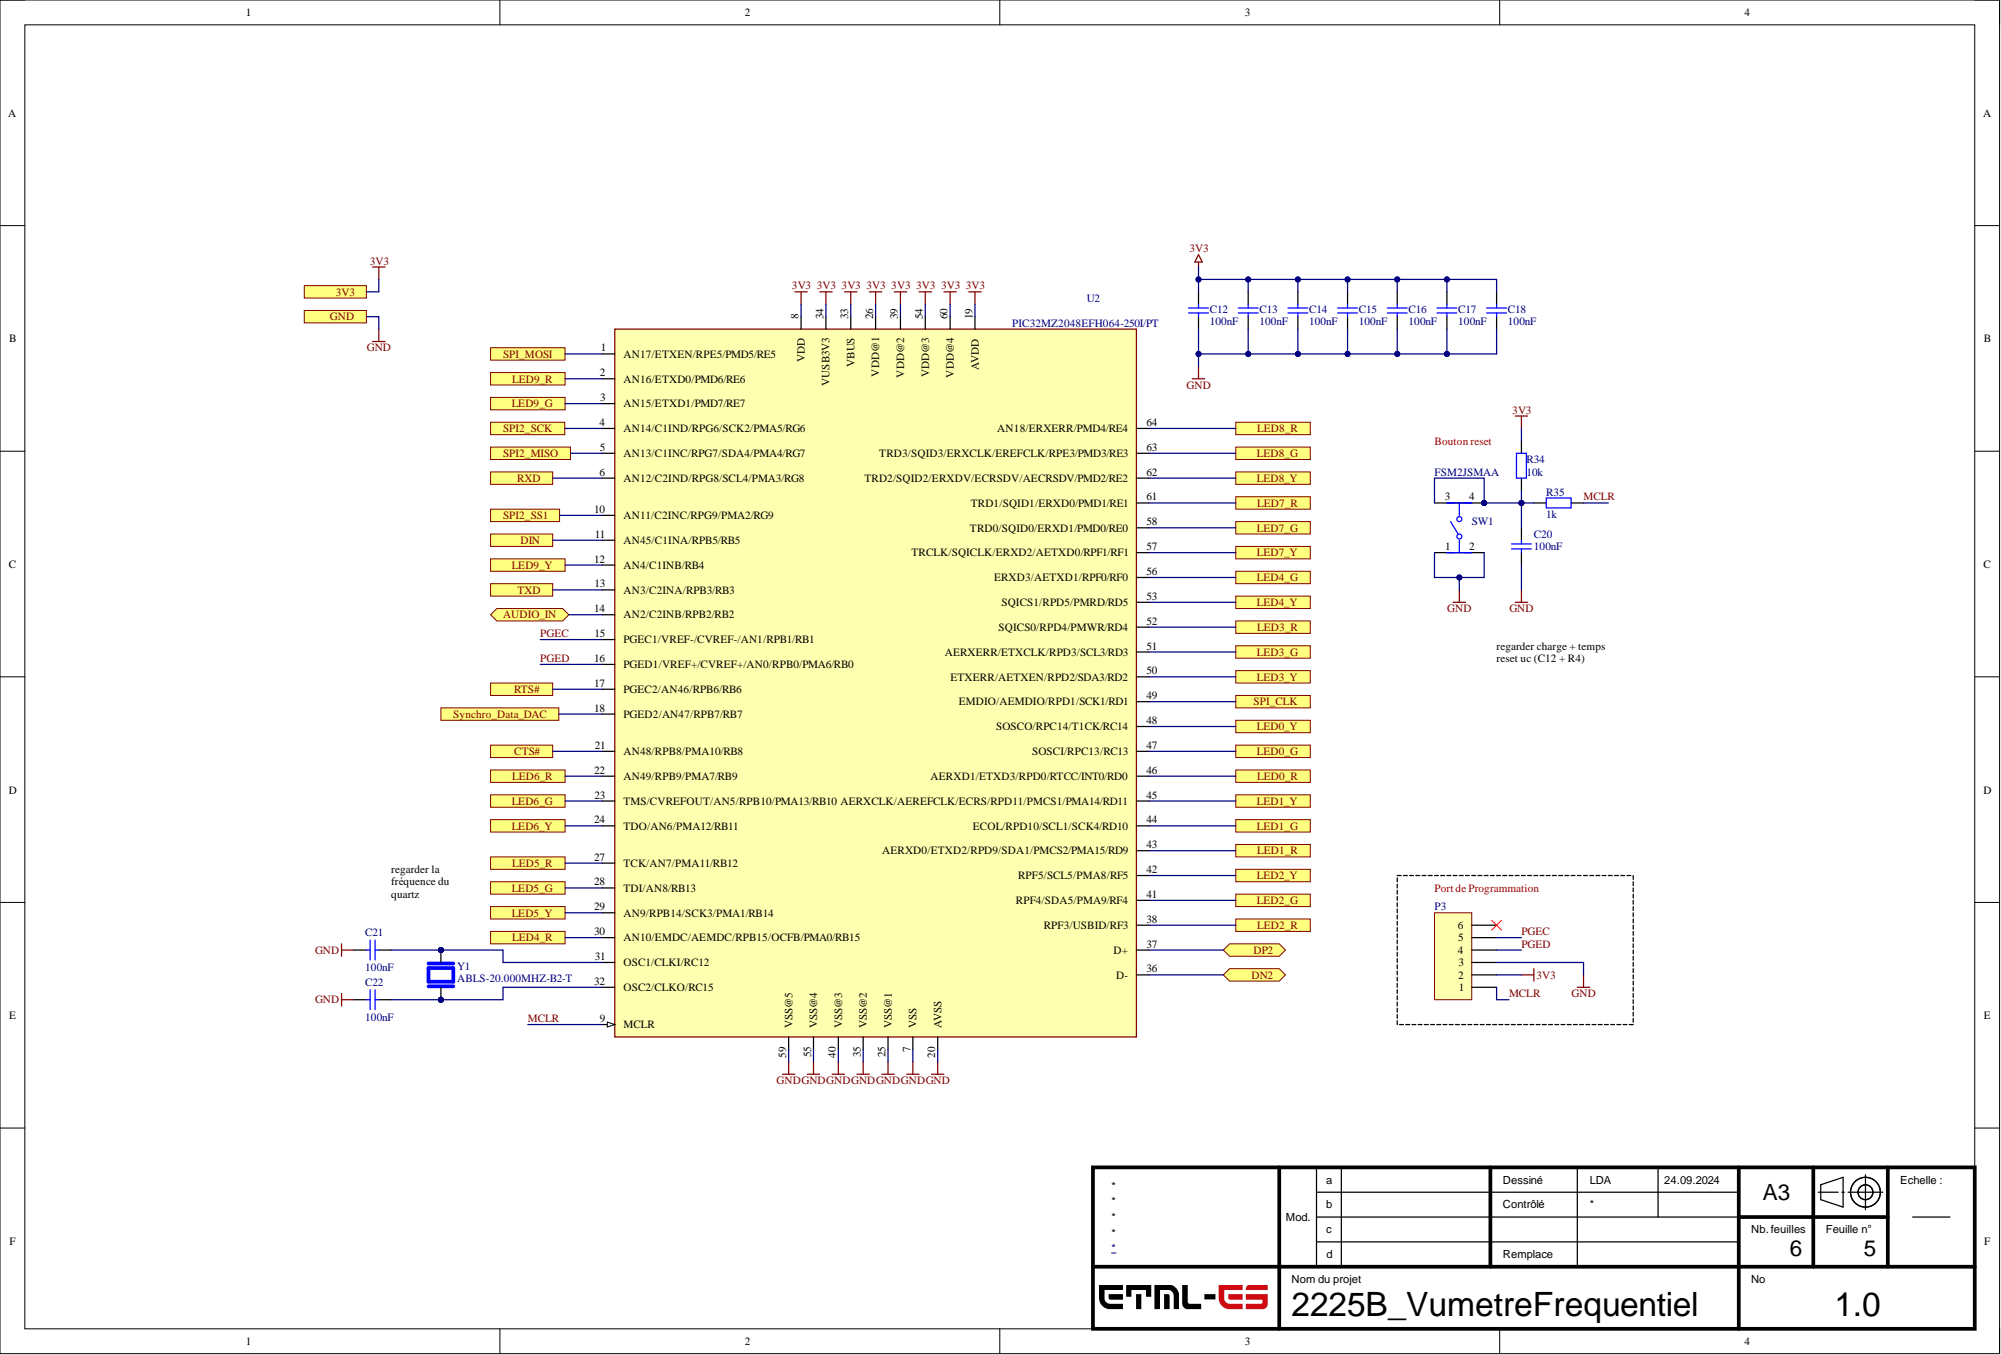
[picture p112: page 5]

** *** | Mod . | | Des s i n é | LD A | 24.09.20 2 4 | A3 | Echelle :

abcd | Cont r ô l é | *

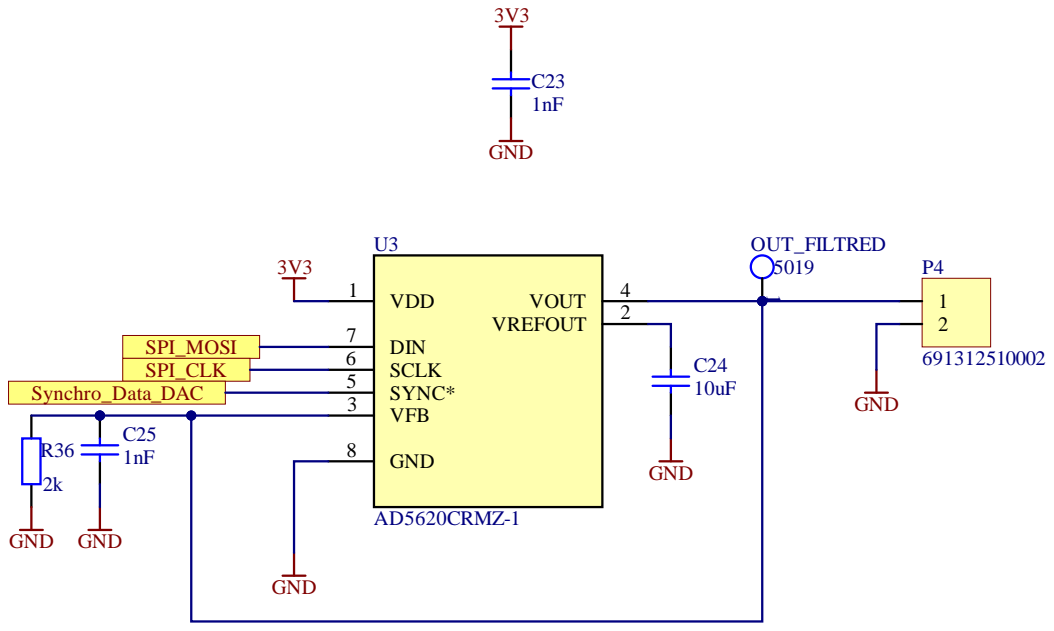
[picture p113: page 6]

DIN 7 | GND 1nF
SPI_MOSI
SPI_CLK

* * * * * | Mod. | a | Dessiné | LDA | 24.09.2024 | A4 | | Echelle :

b | Contrôlé | *

c | | | | Nb. feuilles 6 | Feuille n° 6

d | Remplace
