ETML-ES-SLO/PRJ_2225_VumetreFrequentiel/2225_B/hard/2225B_VumetreFrequenciel_B/Project Outputs for 2225B_VumetreFrequenciel/DesignDocs/2225B_VumetreFrequenciel_PCB Top-Bot Assy Dwgs_Variant_No Variations.PDF

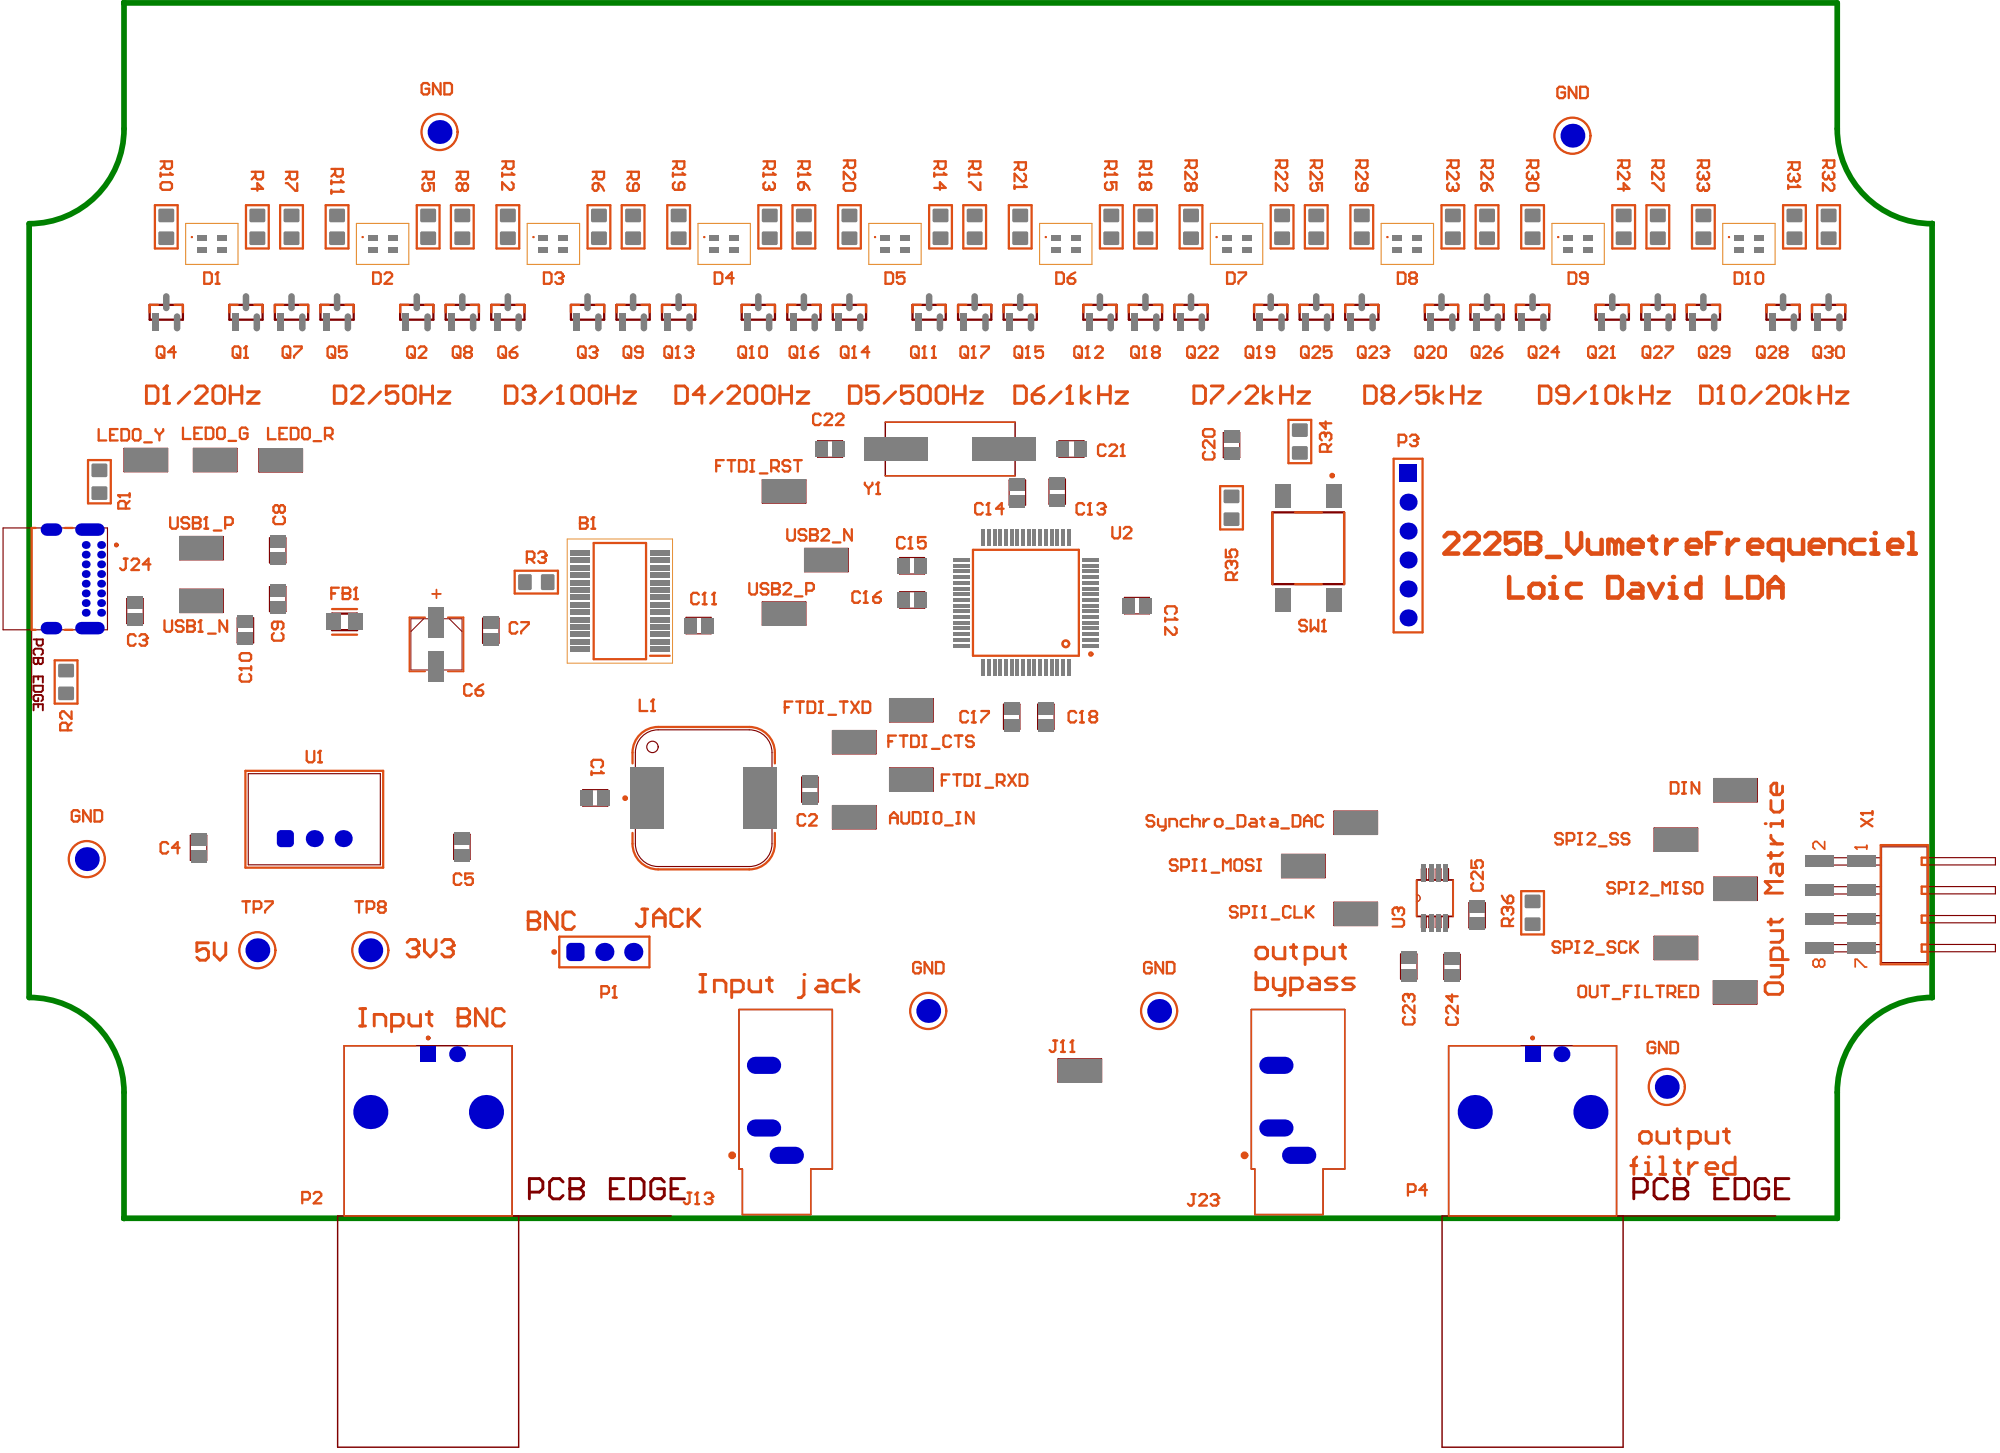
[picture p114: page 1]

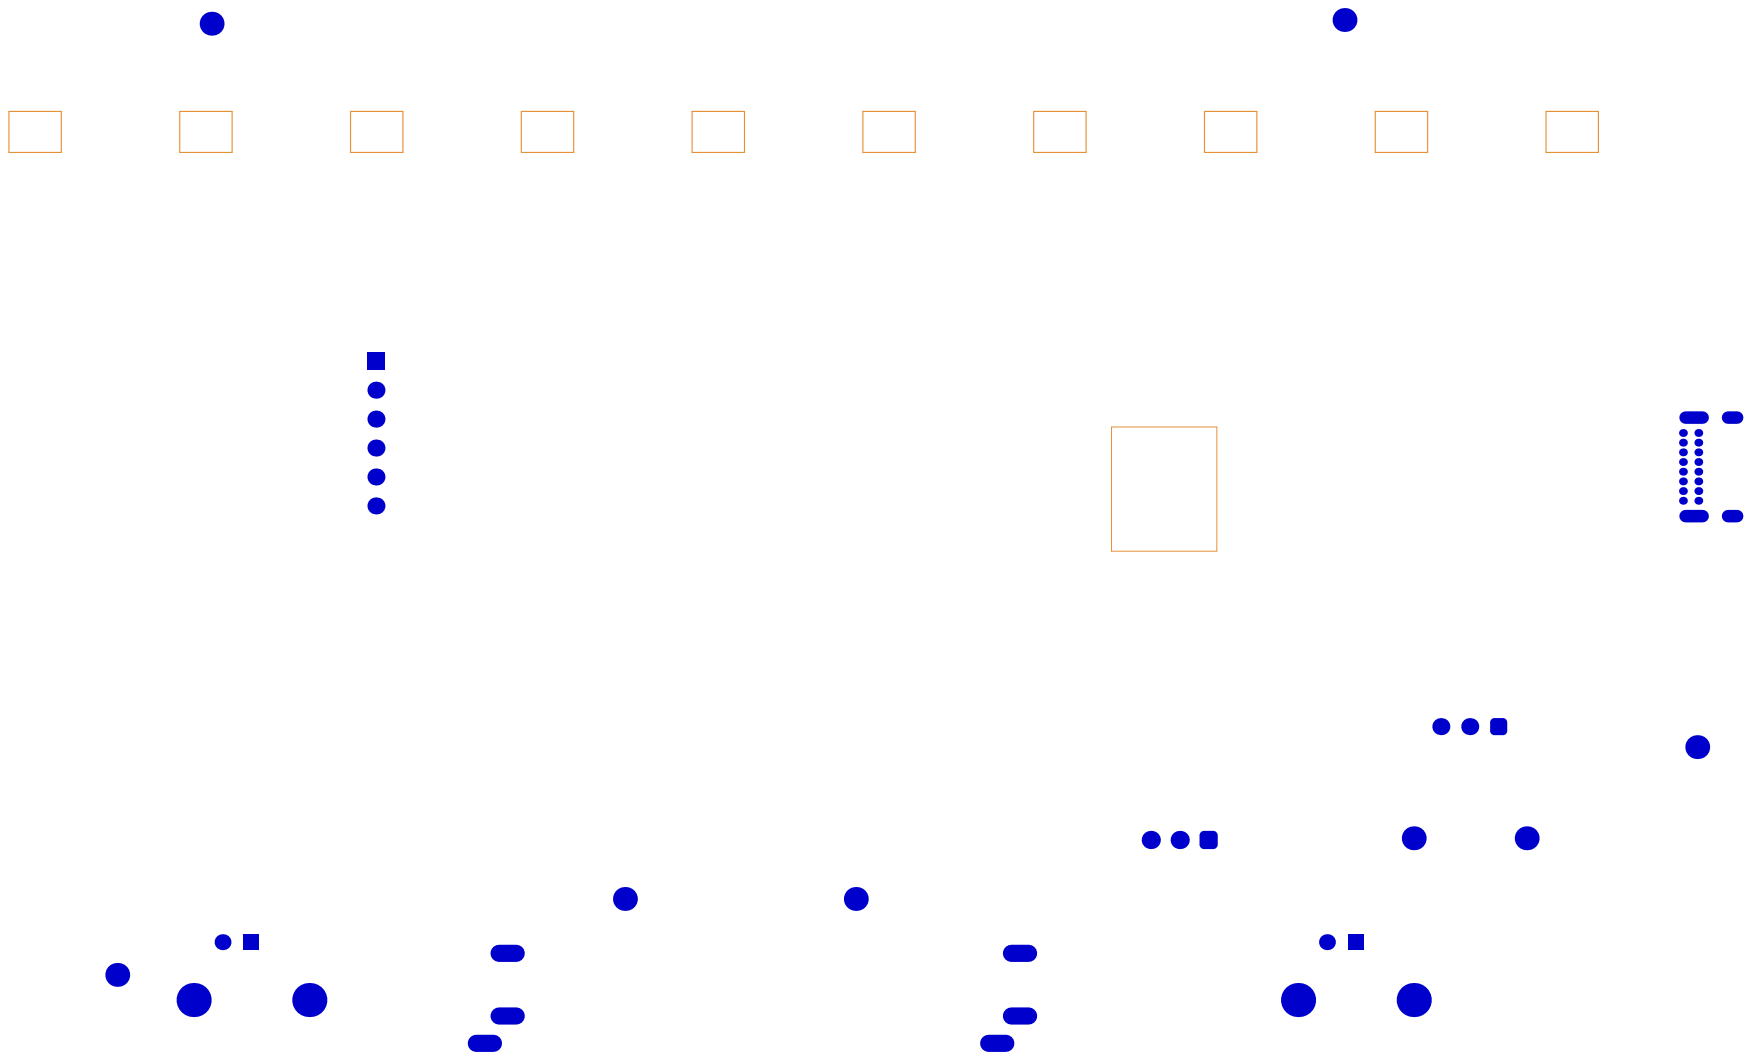
[picture p115: page 2]
