ETML-ES-SLO/PRJ_2225_VumetreFrequentiel/2225_B/hard/2225B_VumetreFrequenciel_B/Project Outputs for 2225B_VumetreFrequenciel/DesignDocs/2225B_VumetreFrequenciel_Schematic_Variant_No Variations.PDF

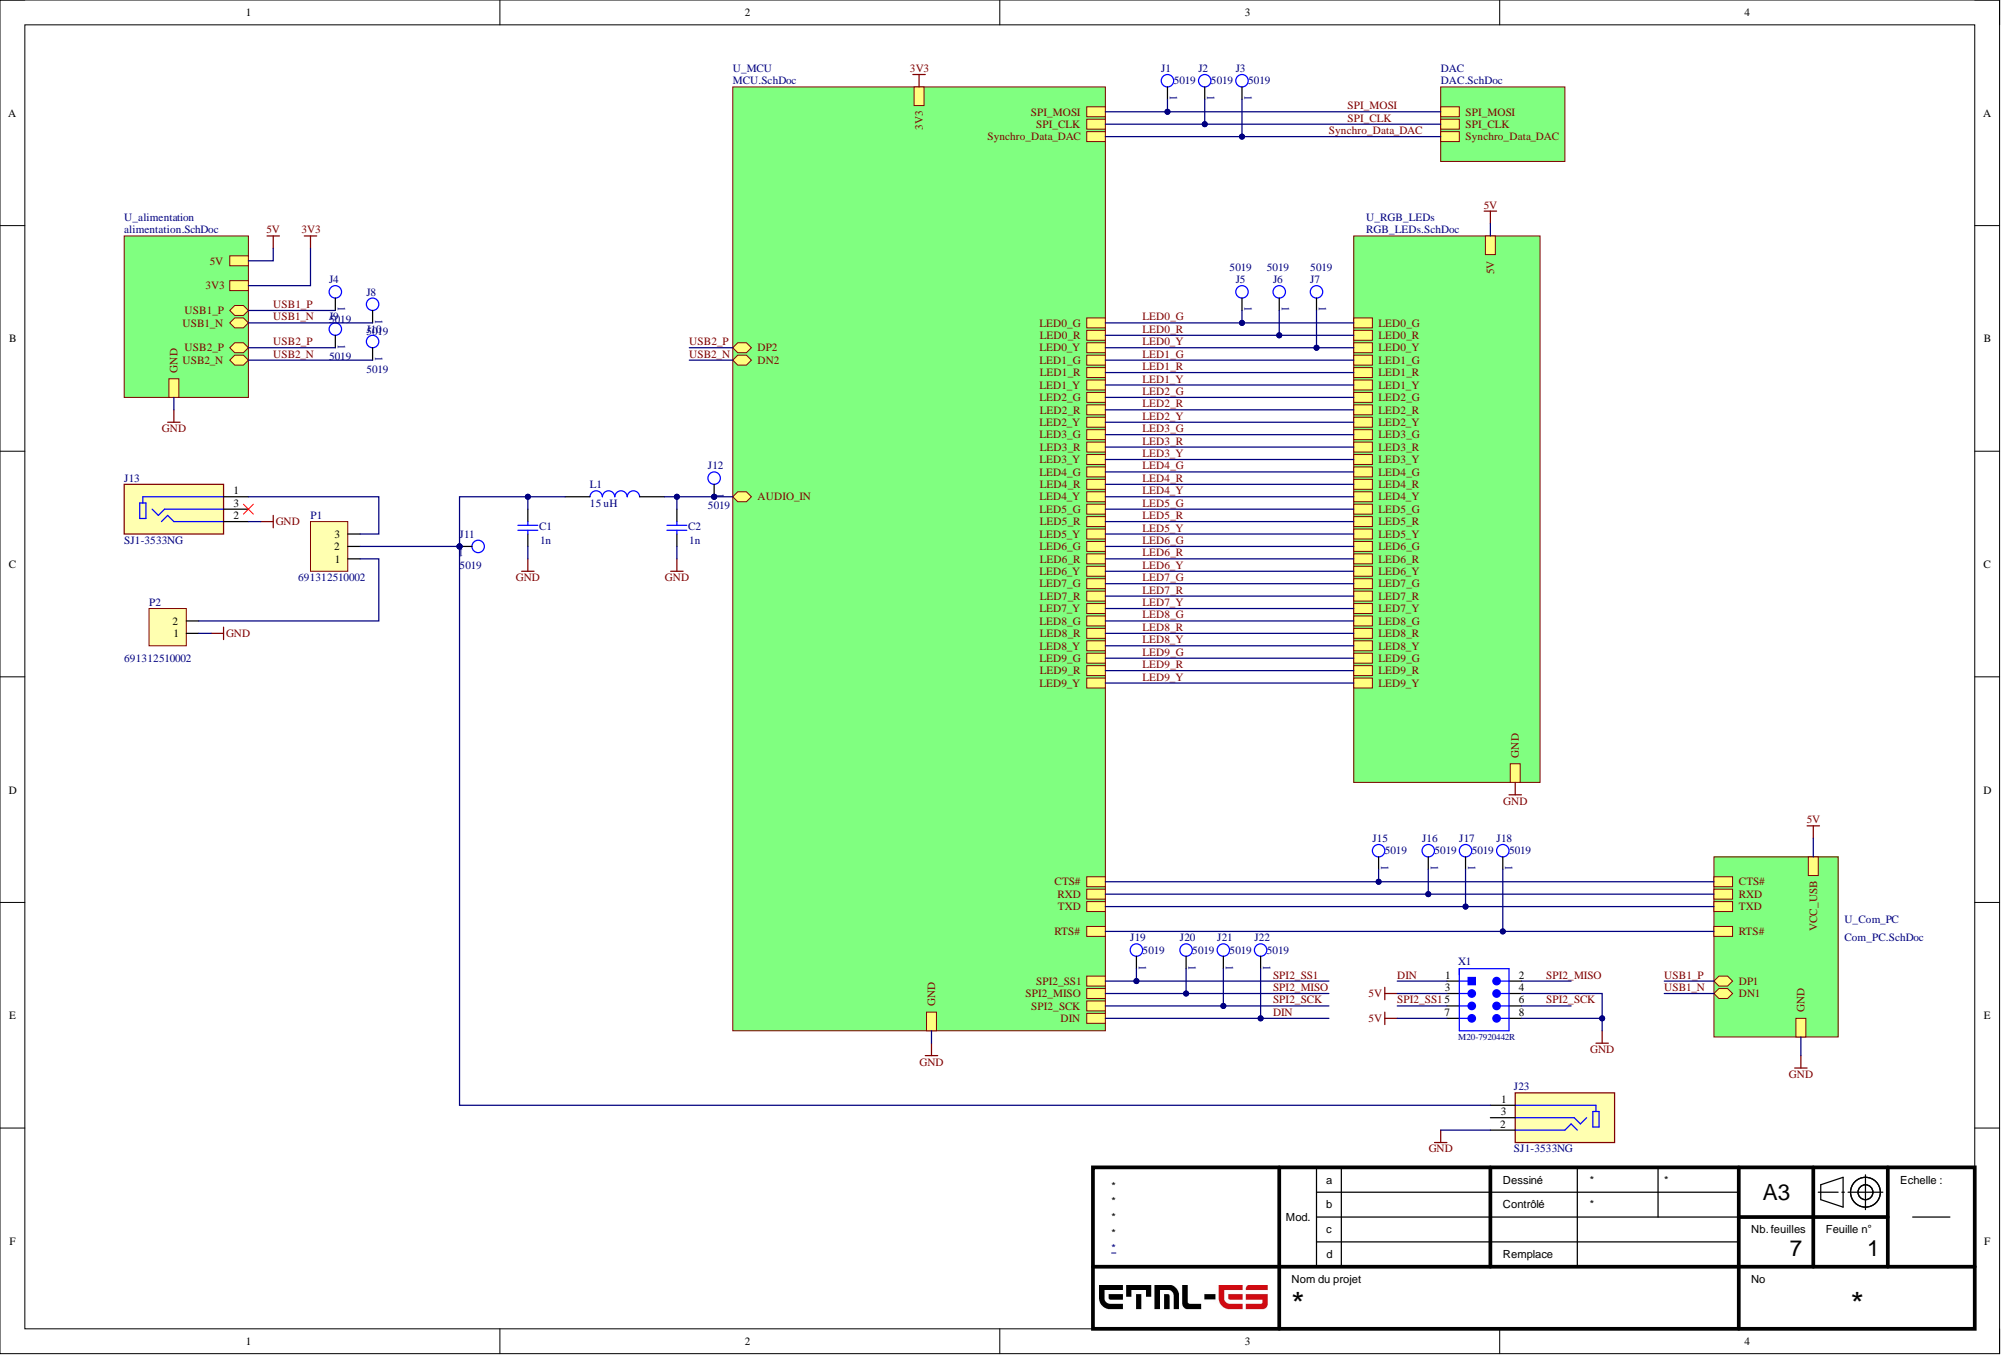
[picture p116: page 1]

SPI_CLK
Synchro_Data_DAC

* * * * * | Mod. | a | Dessiné | * | * | A3 | | Echelle :

b | Contrôlé | *

c | | | | Nb. feuilles 7 | Feuille n° 1

d | Remplace

Nom du projet * | | | | | No *

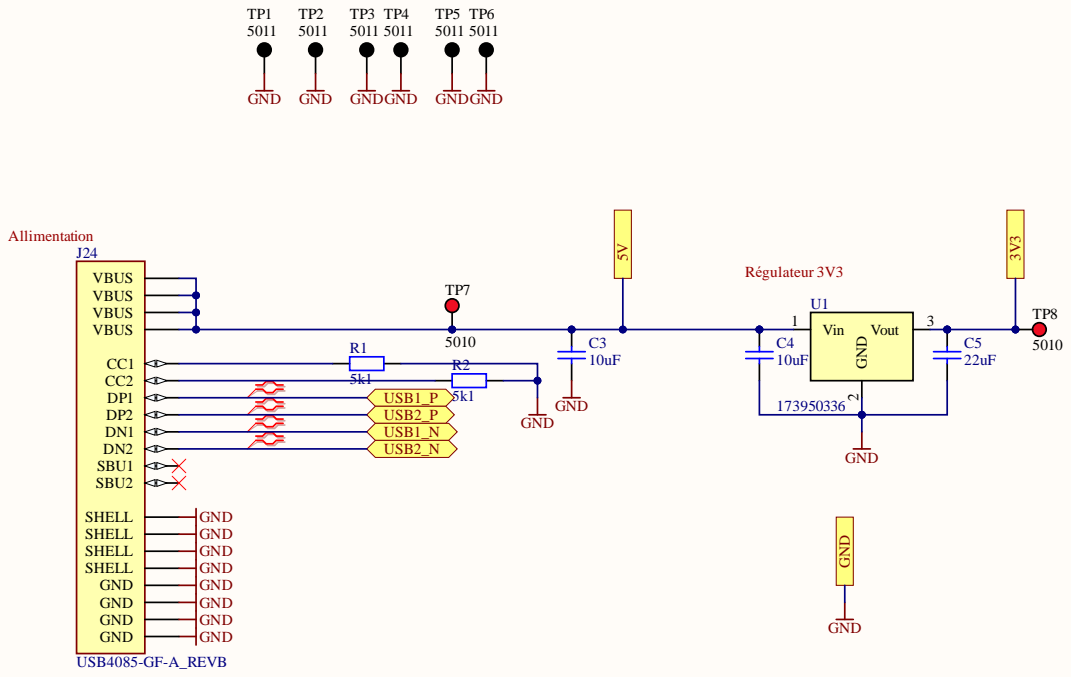
[picture p117: page 2]

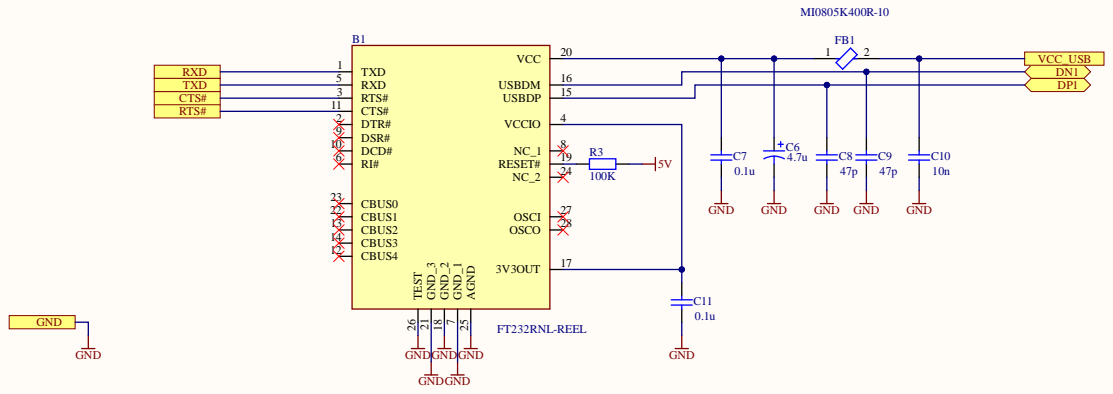
[picture p118: page 3]

3 | 1 5
1 1 | 4

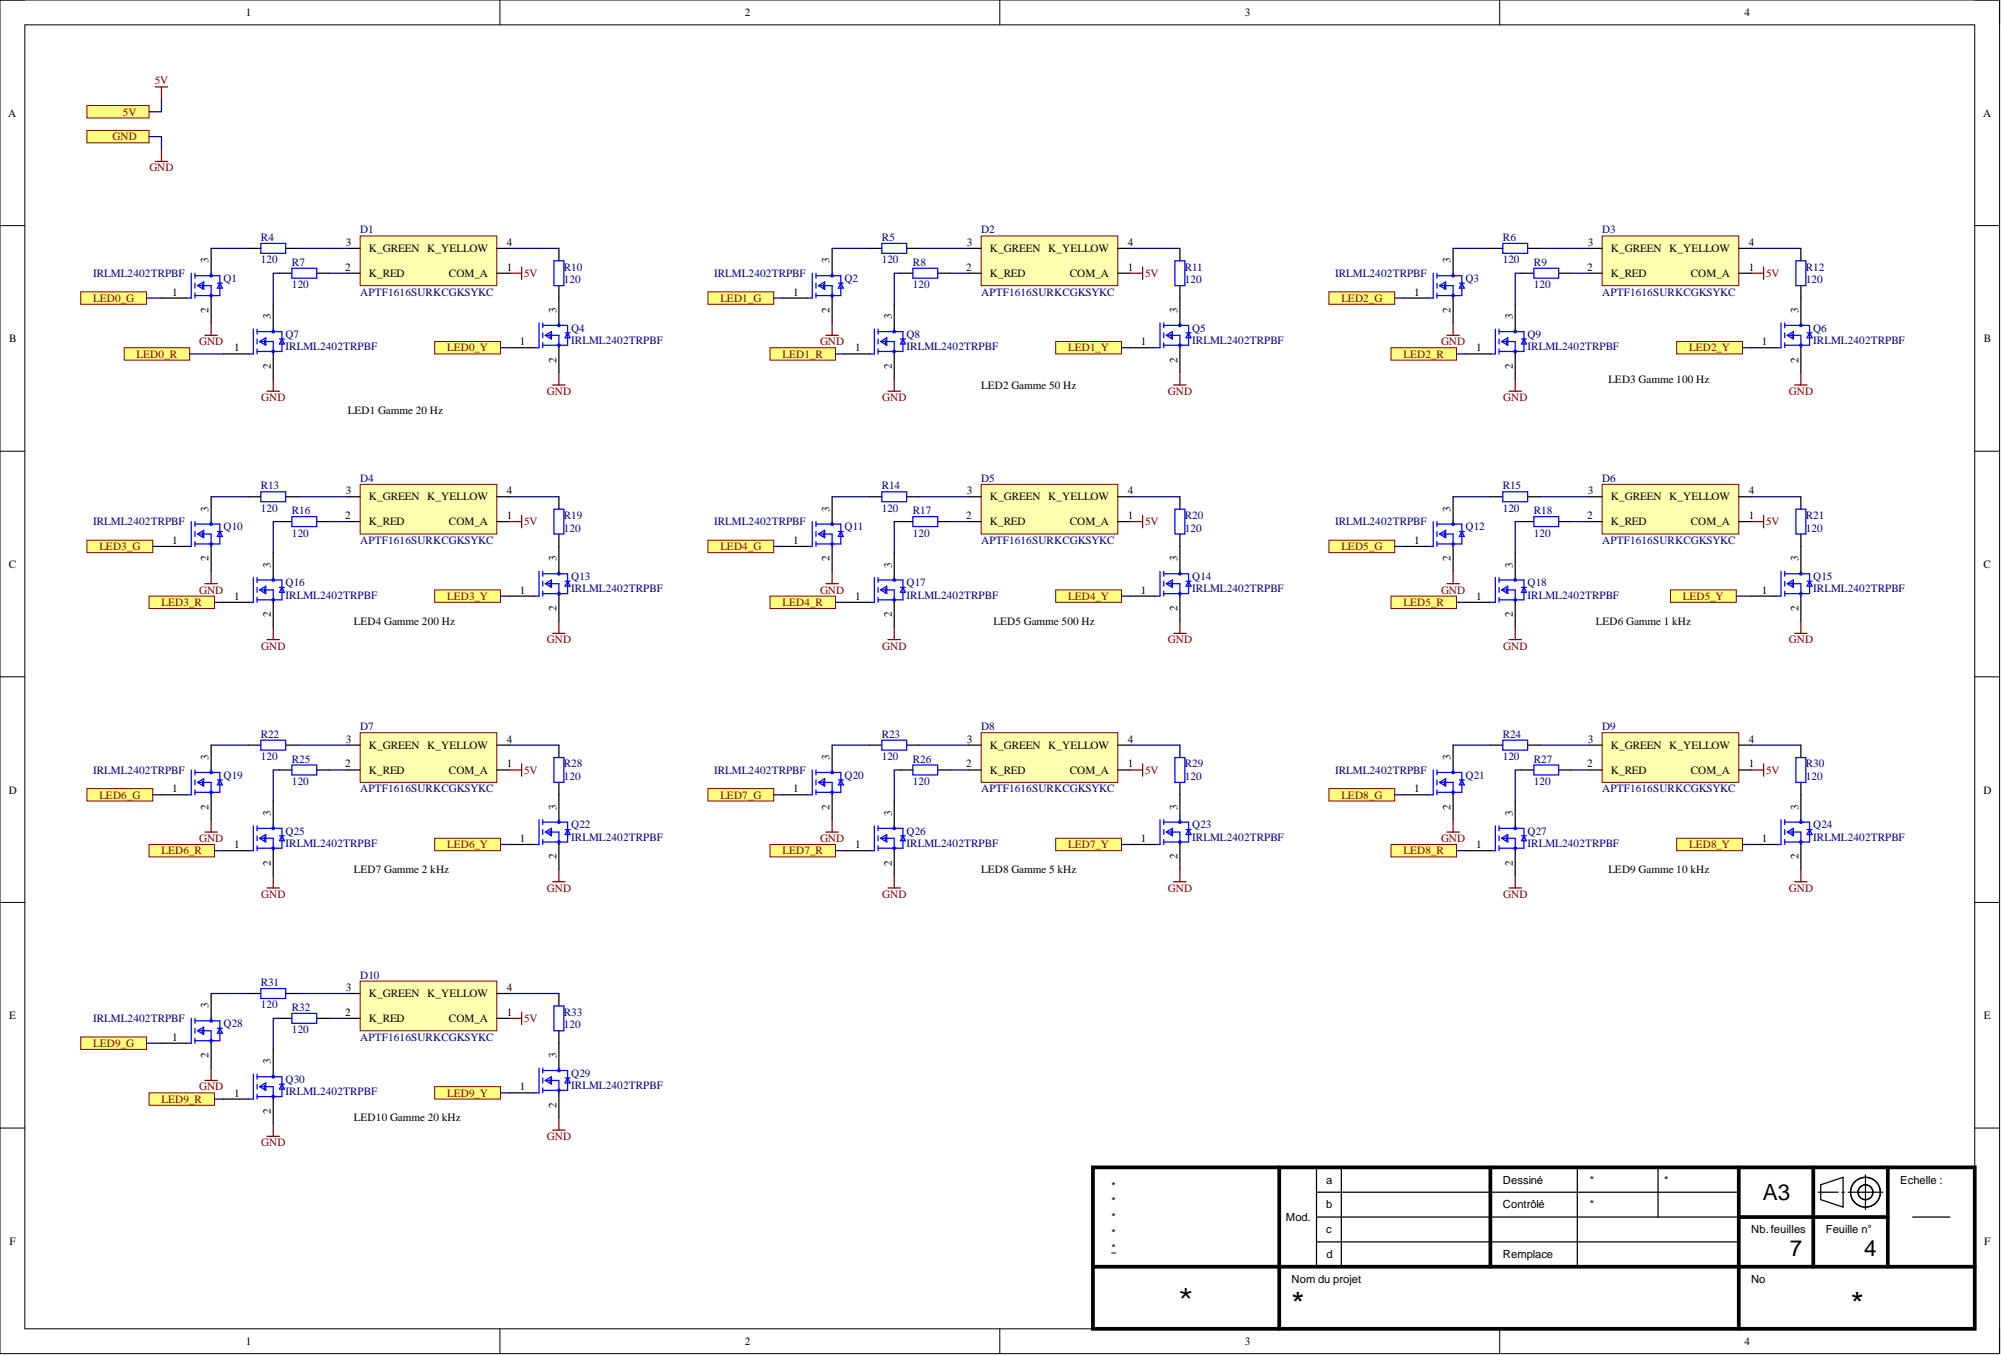
[picture p119: page 4]

* * * * * | Mod. | a | Dessiné | * | * | A3 | | Echelle :

b | Contrôlé | *

c | | | | Nb. feuilles 7 | Feuille n° 4

d | Remplace

* | Nom du projet * | | | | | No *

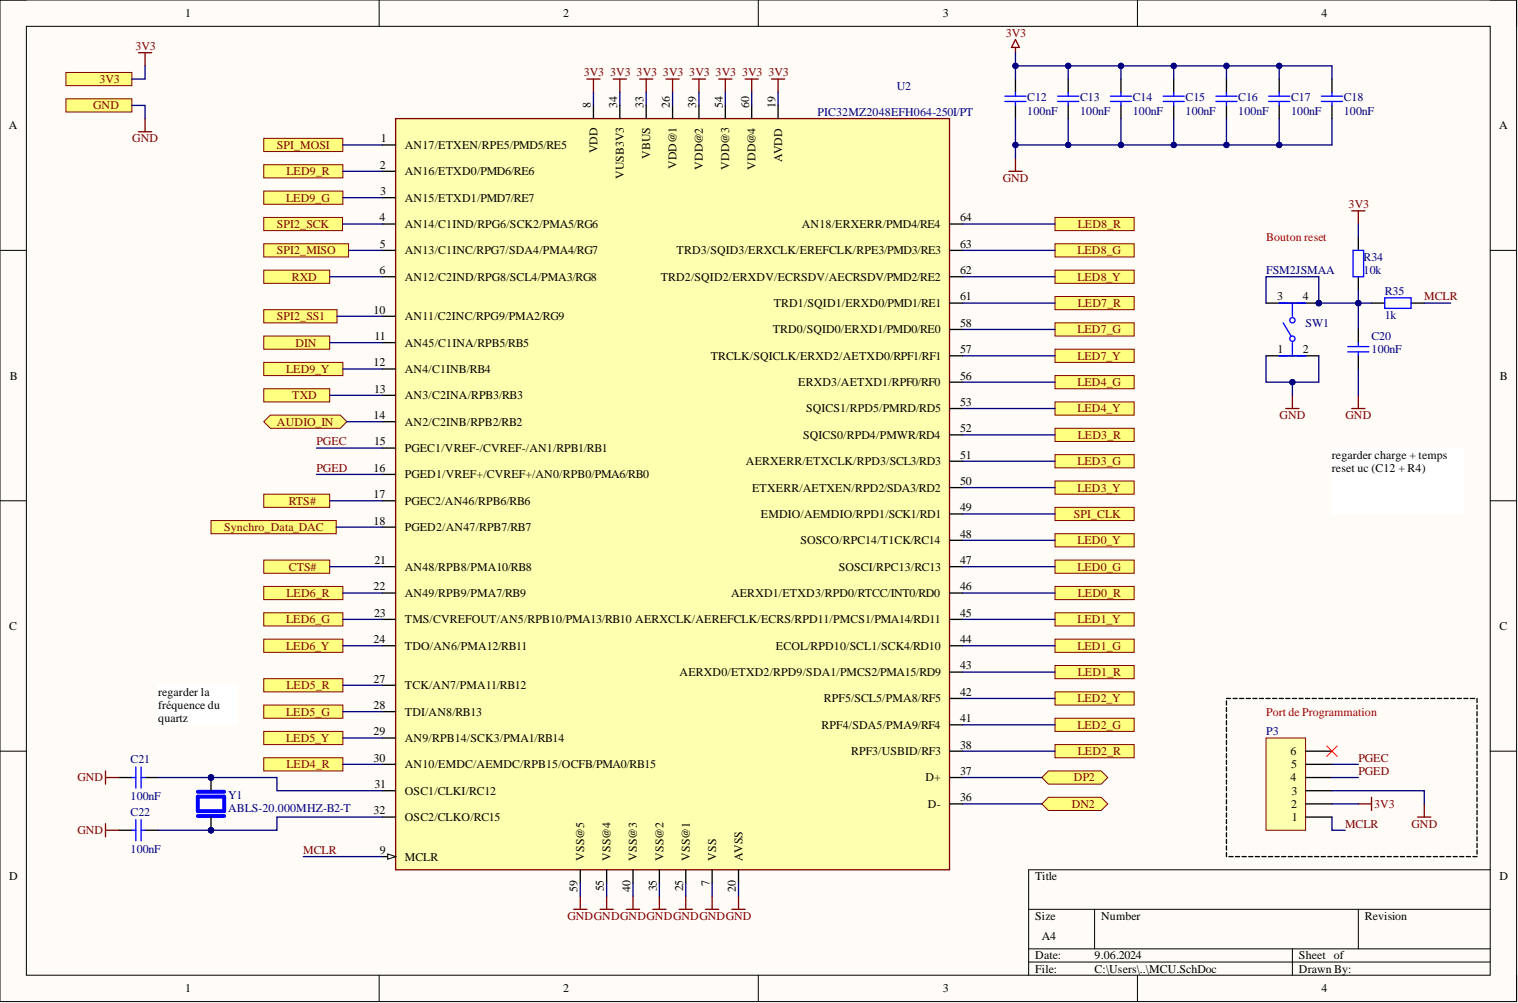
[picture p120: page 5]

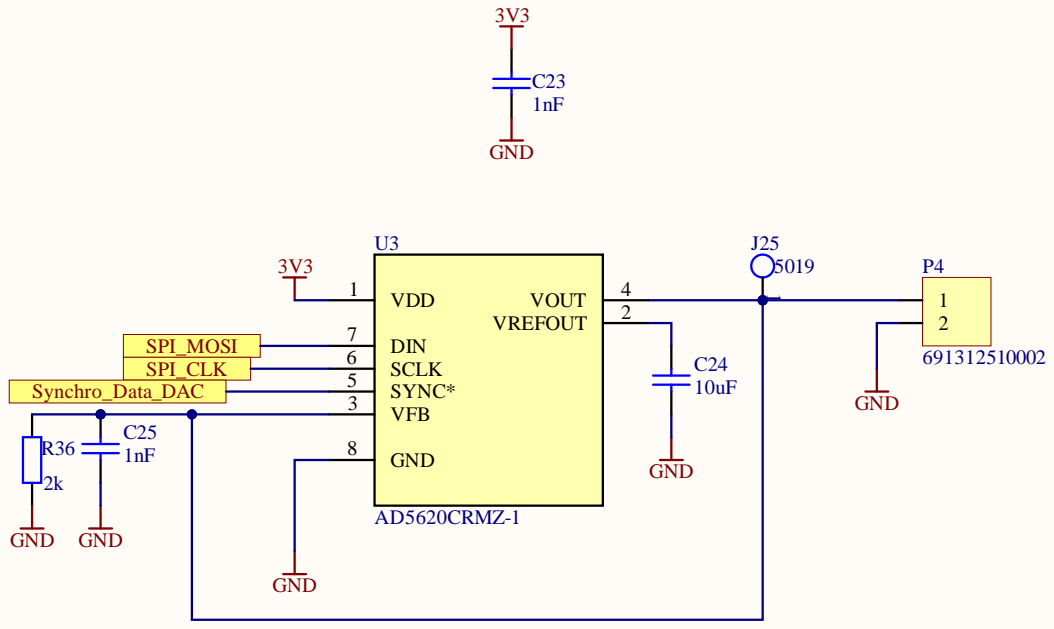
[picture p121: page 6]

SPI_MO | S I
SPI_CL | K

Sy nchro _ Dat a_D A | C

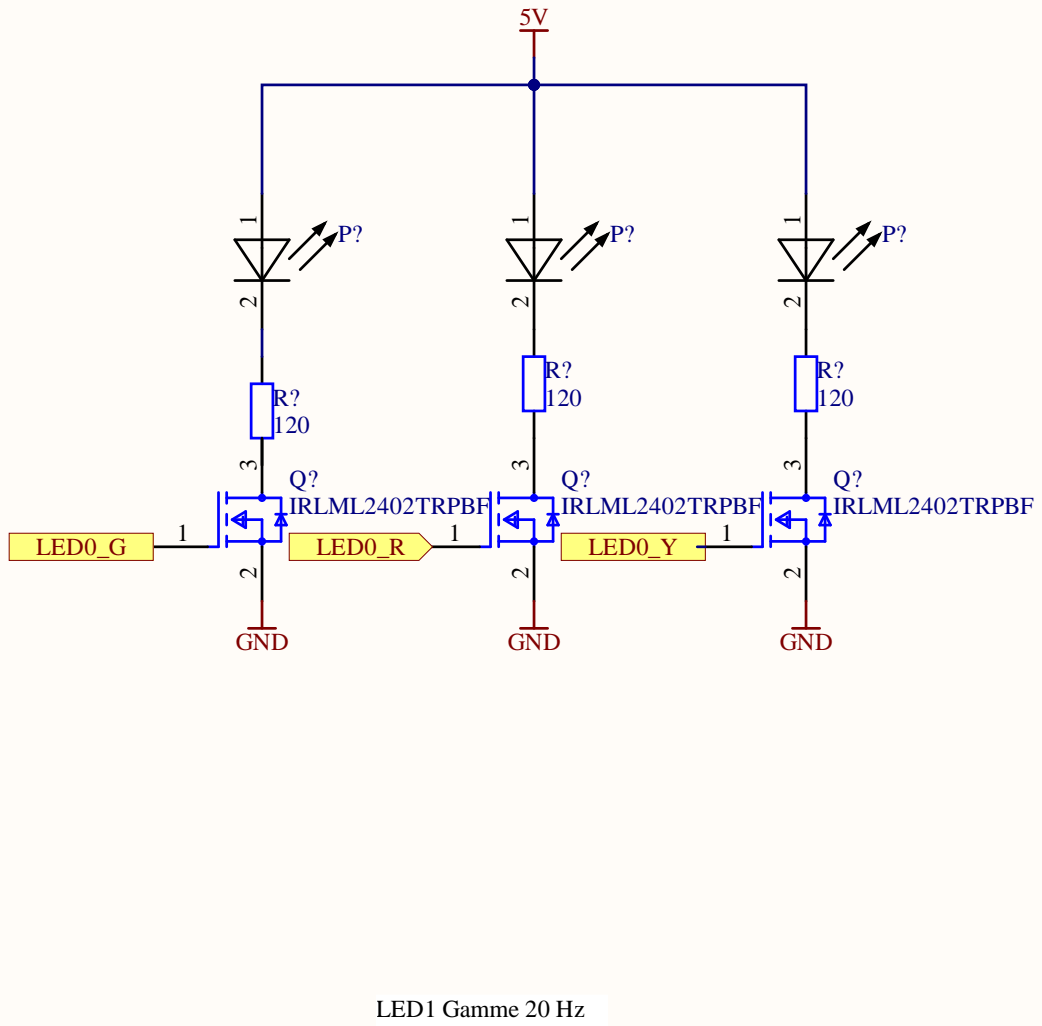
[picture p122: page 7]
