ETML-ES-SLO/PRJ_2225_VumetreFrequentiel/(list of files, drawings)

Other design files:
2225_A/hard/2225_VumetreFrequencemetre - AutoRoot/2225_VumetreFrequencemetre.PcbDoc
2225_A/hard/2225_VumetreFrequencemetre - AutoRoot/2225_VumetreFrequencemetre.PrjPcb
2225_A/hard/2225_VumetreFrequencemetre - AutoRoot/2225_VumetreFrequencemetre.SchDoc
2225_A/hard/2225_VumetreFrequencemetre - Avant placement/2225_VumetreFrequencemetre.PrjPcb
2225_A/hard/2225_VumetreFrequencemetre - Avant placement/2225_VumetreFrequencemetre.SchDoc
2225_A/hard/2225_VumetreFrequencemetre - Avant placement/ES_Class6C_2L.PcbDoc
2225_A/hard/2225_VumetreFrequencemetre - Placement/2225_VumetreFrequencemetre.PrjPcb
2225_A/hard/2225_VumetreFrequencemetre - Placement/2225_VumetreFrequencemetre.SchDoc
2225_A/hard/2225_VumetreFrequencemetre - Placement/ES_Class6C_2L.PcbDoc
2225_A/hard/2225_VumetreFrequencemetre/2225_VumetreFrequencemetre.PrjPcb
2225_A/hard/2225_VumetreFrequencemetre/2225_VumetreFrequencemetre.SchDoc
2225_A/hard/2225_VumetreFrequencemetre/ES_Class6C_2L.PcbDoc
2225_A/hard/Footprints et symboles/Altium_WS-TASV (rev22c)/WS-TASV.PcbLib
2225_A/hard/Footprints et symboles/Altium_WS-TASV (rev22c)/WS-TASV.SchLib
2225_A/hard/Footprints et symboles/BAS40Q-7-F/BAS40Q-7-F/BAS40Q-7-F.SchLib
2225_A/hard/Footprints et symboles/BAS40Q-7-F/BAS40Q-7-F/SOT91P240X110-3N.PcbLib
2225_A/hard/Footprints et symboles/CONBNC002/CONBNC002/CONBNC002.SchLib
2225_A/hard/Footprints et symboles/CONBNC002/CONBNC002/LINX_CONBNC002.PcbLib
2225_A/hard/Footprints et symboles/ECS-100-18-5PX-TR/ECS-100-18-5PX-TR/SnapEDApcb.PcbLib
2225_A/hard/Footprints et symboles/ECS-100-18-5PX-TR/ECS-100-18-5PX-TR/SnapEDAsch.SchLib
2225_A/hard/Footprints et symboles/IC_Microchip_PIC32MX470F512H-120_PT/parts/IC_Microchip_PIC32MX470F512H-120-PT_eec.SchLib
2225_A/hard/Footprints et symboles/IC_Microchip_PIC32MX470F512H-120_PT/parts/IC_Microchip_PIC32MX470F512H-120-PT_eec_0.PcbLib
2225_A/hard/Footprints et symboles/LTST-C191KFKT/LTST-C191KFKT/LEDC1608X55N.PcbLib
2225_A/hard/Footprints et symboles/LTST-C191KFKT/LTST-C191KFKT/LTST-C191KFKT.SchLib
2225_A/hard/Footprints et symboles/MCP6002-E_SN/MCP6002-E_SN/SnapEDApcb.PcbLib
2225_A/hard/Footprints et symboles/MCP6002-E_SN/MCP6002-E_SN/SnapEDAsch.SchLib
2225_A/hard/Footprints et symboles/RASM722PTR13X/RASM722PTR13X/RASM722PTR13X.SchLib
2225_A/hard/Footprints et symboles/RASM722PTR13X/RASM722PTR13X/SWITCHCRAFT_RASM722PTR13X.PcbLib
2225_A/hard/Footprints et symboles/SJ-3523-SMT/SJ-3523-SMT/SnapEDApcb.PcbLib
2225_A/hard/Footprints et symboles/SJ-3523-SMT/SJ-3523-SMT/SnapEDAsch.SchLib
2225_A/hard/Footprints et symboles/SN37A12A/SN37A12A/SN37A12A.SchLib
2225_A/hard/Footprints et symboles/SN37A12A/SN37A12A/SWITCHCRAFT_SN37A12A.PcbLib
2225_A/hard/Footprints et symboles/ul_MAX1793EUE33-/AltiumDesigner/2023-01-25_09-02-42/MAX1793EUE33&plus_.PcbLib
2225_A/hard/Footprints et symboles/ul_MAX1793EUE33-/AltiumDesigner/2023-01-25_09-02-42/MAX1793EUE33&plus_.SchLib
2225_B/doc/datasheets/01_uc/PIC32MZ2048EFH064-250I_PT/SnapEDApcb.PcbLib
2225_B/doc/datasheets/01_uc/PIC32MZ2048EFH064-250I_PT/SnapEDAsch.SchLib
2225_B/doc/datasheets/10_dc-dc converter/Altium_MagI3C-FDSM_rev22e (1)/WPME-FDSM.PcbLib
2225_B/doc/datasheets/10_dc-dc converter/Altium_MagI3C-FDSM_rev22e (1)/WPME-FDSM.SchLib
2225_B/doc/datasheets/40_LEDs/LIB_APTF1616SURKCGKSYKC/APTF1616SURKCGKSYKC/Altium/APTF1616SURKCGKSYKC.PcbLib
2225_B/doc/datasheets/40_LEDs/LIB_APTF1616SURKCGKSYKC/APTF1616SURKCGKSYKC/Altium/APTF1616SURKCGKSYKC.SchLib
2225_B/doc/datasheets/41_Cap_Pol/4.7u/10SVP4R7M/AltiumDesigner/10SVP4R7M.PcbLib
2225_B/doc/datasheets/41_Cap_Pol/4.7u/10SVP4R7M/AltiumDesigner/10SVP4R7M.SchLib
2225_B/doc/datasheets/42_inductors/744770115/Altium_WE-PD_rev22g/WE-PD.PcbLib
2225_B/doc/datasheets/42_inductors/744770115/Altium_WE-PD_rev22g/WE-PD.SchLib
2225_B/doc/datasheets/50_Connectors/BNC/CONBNC002/CONBNC002/CONBNC002.SchLib
2225_B/doc/datasheets/50_Connectors/BNC/CONBNC002/CONBNC002/LINX_CONBNC002.PcbLib
2225_B/doc/datasheets/50_Connectors/USB-C/USB4085-GF-A_REVB/GCT_USB4085-GF-A_REVB.PcbLib
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
