ETML-ES-SLO/PRJ_2225_VumetreFrequentiel/2225_A/soft/firmware/src/system_config/default/system_config.h

/*******************************************************************************
  MPLAB Harmony System Configuration Header

  File Name:
    system_config.h

  Summary:
    Build-time configuration header for the system defined by this MPLAB Harmony
    project.

  Description:
    An MPLAB Project may have multiple configurations.  This file defines the
    build-time options for a single configuration.

  Remarks:
    This configuration header must not define any prototypes or data
    definitions (or include any files that do).  It only provides macro
    definitions for build-time configuration options that are not instantiated
    until used by another MPLAB Harmony module or application.

    Created with MPLAB Harmony Version 2.06
*******************************************************************************/

// DOM-IGNORE-BEGIN
/*******************************************************************************
Copyright (c) 2013-2015 released Microchip Technology Inc.  All rights reserved.

Microchip licenses to you the right to use, modify, copy and distribute
Software only when embedded on a Microchip microcontroller or digital signal
controller that is integrated into your product or third party product
(pursuant to the sublicense terms in the accompanying license agreement).

You should refer to the license agreement accompanying this Software for
additional information regarding your rights and obligations.

SOFTWARE AND DOCUMENTATION ARE PROVIDED AS IS WITHOUT WARRANTY OF ANY KIND,
EITHER EXPRESS OR IMPLIED, INCLUDING WITHOUT LIMITATION, ANY WARRANTY OF
MERCHANTABILITY, TITLE, NON-INFRINGEMENT AND FITNESS FOR A PARTICULAR PURPOSE.
IN NO EVENT SHALL MICROCHIP OR ITS LICENSORS BE LIABLE OR OBLIGATED UNDER
CONTRACT, NEGLIGENCE, STRICT LIABILITY, CONTRIBUTION, BREACH OF WARRANTY, OR
OTHER LEGAL EQUITABLE THEORY ANY DIRECT OR INDIRECT DAMAGES OR EXPENSES
INCLUDING BUT NOT LIMITED TO ANY INCIDENTAL, SPECIAL, INDIRECT, PUNITIVE OR
CONSEQUENTIAL DAMAGES, LOST PROFITS OR LOST DATA, COST OF PROCUREMENT OF
SUBSTITUTE GOODS, TECHNOLOGY, SERVICES, OR ANY CLAIMS BY THIRD PARTIES
(INCLUDING BUT NOT LIMITED TO ANY DEFENSE THEREOF), OR OTHER SIMILAR COSTS.
*******************************************************************************/
// DOM-IGNORE-END

#ifndef _SYSTEM_CONFIG_H
#define _SYSTEM_CONFIG_H

// *****************************************************************************
// *****************************************************************************
// Section: Included Files
// *****************************************************************************
// *****************************************************************************
/*  This section Includes other configuration headers necessary to completely
    define this configuration.
*/


// DOM-IGNORE-BEGIN
#ifdef __cplusplus  // Provide C++ Compatibility

extern "C" {

#endif
// DOM-IGNORE-END

// *****************************************************************************
// *****************************************************************************
// Section: System Service Configuration
// *****************************************************************************
// *****************************************************************************
// *****************************************************************************
/* Common System Service Configuration Options
*/
#define SYS_VERSION_STR           "2.06"
#define SYS_VERSION               20600

// *****************************************************************************
/* Clock System Service Configuration Options
*/
#define SYS_CLK_FREQ                        80000000ul
#define SYS_CLK_BUS_PERIPHERAL_1            80000000ul
#define SYS_CLK_UPLL_BEFORE_DIV2_FREQ       120000000ul
#define SYS_CLK_CONFIG_PRIMARY_XTAL         10000000ul
#define SYS_CLK_CONFIG_SECONDARY_XTAL       32768ul
   
/*** Ports System Service Configuration ***/
#define SYS_PORT_B_ANSEL        0xFFFF
#define SYS_PORT_B_TRIS         0xFFFF
#define SYS_PORT_B_LAT          0x0000
#define SYS_PORT_B_ODC          0x0000
#define SYS_PORT_B_CNPU         0x0000
#define SYS_PORT_B_CNPD         0x0000
#define SYS_PORT_B_CNEN         0x0000

#define SYS_PORT_C_ANSEL        0xFFFF
#define SYS_PORT_C_TRIS         0xFFFF
#define SYS_PORT_C_LAT          0x0000
#define SYS_PORT_C_ODC          0x0000
#define SYS_PORT_C_CNPU         0x0000
#define SYS_PORT_C_CNPD         0x0000
#define SYS_PORT_C_CNEN         0x0000

#define SYS_PORT_D_ANSEL        0xF00E
#define SYS_PORT_D_TRIS         0xF08E
#define SYS_PORT_D_LAT          0x0000
#define SYS_PORT_D_ODC          0x0000
#define SYS_PORT_D_CNPU         0x0000
#define SYS_PORT_D_CNPD         0x0000
#define SYS_PORT_D_CNEN         0x0000

#define SYS_PORT_E_ANSEL        0xFF00
#define SYS_PORT_E_TRIS         0xFF00
#define SYS_PORT_E_LAT          0x0000
#define SYS_PORT_E_ODC          0x0000
#define SYS_PORT_E_CNPU         0x0000
#define SYS_PORT_E_CNPD         0x0000
#define SYS_PORT_E_CNEN         0x0000

#define SYS_PORT_F_ANSEL        0xFFC4
#define SYS_PORT_F_TRIS         0xFFFF
#define SYS_PORT_F_LAT          0x0000
#define SYS_PORT_F_ODC          0x0000
#define SYS_PORT_F_CNPU         0x0000
#define SYS_PORT_F_CNPD         0x0000
#define SYS_PORT_F_CNEN         0x0000

#define SYS_PORT_G_ANSEL        0xFC3F
#define SYS_PORT_G_TRIS         0xFC3F
#define SYS_PORT_G_LAT          0x0000
#define SYS_PORT_G_ODC          0x0000
#define SYS_PORT_G_CNPU         0x0000
#define SYS_PORT_G_CNPD         0x0000
#define SYS_PORT_G_CNEN         0x0000


/*** Interrupt System Service Configuration ***/
#define SYS_INT                     true

// *****************************************************************************
// *****************************************************************************
// Section: Driver Configuration
// *****************************************************************************
// *****************************************************************************
/*** Timer Driver Configuration ***/
#define DRV_TMR_INTERRUPT_MODE             true

/*** Timer Driver 0 Configuration ***/
#define DRV_TMR_PERIPHERAL_ID_IDX0          TMR_ID_1
#define DRV_TMR_INTERRUPT_SOURCE_IDX0       INT_SOURCE_TIMER_1
#define DRV_TMR_INTERRUPT_VECTOR_IDX0       INT_VECTOR_T1
#define DRV_TMR_ISR_VECTOR_IDX0             _TIMER_1_VECTOR
#define DRV_TMR_INTERRUPT_PRIORITY_IDX0     INT_PRIORITY_LEVEL1
#define DRV_TMR_INTERRUPT_SUB_PRIORITY_IDX0 INT_SUBPRIORITY_LEVEL0
#define DRV_TMR_CLOCK_SOURCE_IDX0           DRV_TMR_CLKSOURCE_INTERNAL
#define DRV_TMR_PRESCALE_IDX0               TMR_PRESCALE_VALUE_8
#define DRV_TMR_OPERATION_MODE_IDX0         DRV_TMR_OPERATION_MODE_16_BIT
#define DRV_TMR_ASYNC_WRITE_ENABLE_IDX0     false
#define DRV_TMR_POWER_STATE_IDX0            

#define DRV_TMR_PERIPHERAL_ID_IDX1          TMR_ID_3
#define DRV_TMR_INTERRUPT_SOURCE_IDX1       INT_SOURCE_TIMER_3
#define DRV_TMR_INTERRUPT_VECTOR_IDX1       INT_VECTOR_T3
#define DRV_TMR_ISR_VECTOR_IDX1             _TIMER_3_VECTOR
#define DRV_TMR_INTERRUPT_PRIORITY_IDX1     INT_DISABLE_INTERRUPT
#define DRV_TMR_INTERRUPT_SUB_PRIORITY_IDX1 INT_SUBPRIORITY_LEVEL0
#define DRV_TMR_CLOCK_SOURCE_IDX1           DRV_TMR_CLKSOURCE_INTERNAL
#define DRV_TMR_PRESCALE_IDX1               TMR_PRESCALE_VALUE_1
#define DRV_TMR_OPERATION_MODE_IDX1         DRV_TMR_OPERATION_MODE_16_BIT

#define DRV_TMR_ASYNC_WRITE_ENABLE_IDX1     false
#define DRV_TMR_POWER_STATE_IDX1            

 
// *****************************************************************************
// *****************************************************************************
// Section: Middleware & Other Library Configuration
// *****************************************************************************
// *****************************************************************************



// *****************************************************************************
// *****************************************************************************
// Section: Application Configuration
// *****************************************************************************
// *****************************************************************************
/*** Application Defined Pins ***/

/*** Functions for LED5 pin ***/
#define LED5Toggle() PLIB_PORTS_PinToggle(PORTS_ID_0, PORT_CHANNEL_E, PORTS_BIT_POS_5)
#define LED5On() PLIB_PORTS_PinSet(PORTS_ID_0, PORT_CHANNEL_E, PORTS_BIT_POS_5)
#define LED5Off() PLIB_PORTS_PinClear(PORTS_ID_0, PORT_CHANNEL_E, PORTS_BIT_POS_5)
#define LED5StateGet() PLIB_PORTS_PinGetLatched(PORTS_ID_0, PORT_CHANNEL_E, PORTS_BIT_POS_5)
#define LED5StateSet(Value) PLIB_PORTS_PinWrite(PORTS_ID_0, PORT_CHANNEL_E, PORTS_BIT_POS_5, Value)

/*** Functions for LED6 pin ***/
#define LED6Toggle() PLIB_PORTS_PinToggle(PORTS_ID_0, PORT_CHANNEL_E, PORTS_BIT_POS_6)
#define LED6On() PLIB_PORTS_PinSet(PORTS_ID_0, PORT_CHANNEL_E, PORTS_BIT_POS_6)
#define LED6Off() PLIB_PORTS_PinClear(PORTS_ID_0, PORT_CHANNEL_E, PORTS_BIT_POS_6)
#define LED6StateGet() PLIB_PORTS_PinGetLatched(PORTS_ID_0, PORT_CHANNEL_E, PORTS_BIT_POS_6)
#define LED6StateSet(Value) PLIB_PORTS_PinWrite(PORTS_ID_0, PORT_CHANNEL_E, PORTS_BIT_POS_6, Value)

/*** Functions for LED7 pin ***/
#define LED7Toggle() PLIB_PORTS_PinToggle(PORTS_ID_0, PORT_CHANNEL_E, PORTS_BIT_POS_7)
#define LED7On() PLIB_PORTS_PinSet(PORTS_ID_0, PORT_CHANNEL_E, PORTS_BIT_POS_7)
#define LED7Off() PLIB_PORTS_PinClear(PORTS_ID_0, PORT_CHANNEL_E, PORTS_BIT_POS_7)
#define LED7StateGet() PLIB_PORTS_PinGetLatched(PORTS_ID_0, PORT_CHANNEL_E, PORTS_BIT_POS_7)
#define LED7StateSet(Value) PLIB_PORTS_PinWrite(PORTS_ID_0, PORT_CHANNEL_E, PORTS_BIT_POS_7, Value)

/*** Functions for DOUT pin ***/
#define DOUTToggle() PLIB_PORTS_PinToggle(PORTS_ID_0, PORT_CHANNEL_G, PORTS_BIT_POS_6)
#define DOUTOn() PLIB_PORTS_PinSet(PORTS_ID_0, PORT_CHANNEL_G, PORTS_BIT_POS_6)
#define DOUTOff() PLIB_PORTS_PinClear(PORTS_ID_0, PORT_CHANNEL_G, PORTS_BIT_POS_6)
#define DOUTStateGet() PLIB_PORTS_PinGetLatched(PORTS_ID_0, PORT_CHANNEL_G, PORTS_BIT_POS_6)
#define DOUTStateSet(Value) PLIB_PORTS_PinWrite(PORTS_ID_0, PORT_CHANNEL_G, PORTS_BIT_POS_6, Value)

/*** Functions for MISO pin ***/
#define MISOToggle() PLIB_PORTS_PinToggle(PORTS_ID_0, PORT_CHANNEL_G, PORTS_BIT_POS_7)
#define MISOOn() PLIB_PORTS_PinSet(PORTS_ID_0, PORT_CHANNEL_G, PORTS_BIT_POS_7)
#define MISOOff() PLIB_PORTS_PinClear(PORTS_ID_0, PORT_CHANNEL_G, PORTS_BIT_POS_7)
#define MISOStateGet() PLIB_PORTS_PinGetLatched(PORTS_ID_0, PORT_CHANNEL_G, PORTS_BIT_POS_7)
#define MISOStateSet(Value) PLIB_PORTS_PinWrite(PORTS_ID_0, PORT_CHANNEL_G, PORTS_BIT_POS_7, Value)

/*** Functions for SS1 pin ***/
#define SS1Toggle() PLIB_PORTS_PinToggle(PORTS_ID_0, PORT_CHANNEL_G, PORTS_BIT_POS_8)
#define SS1On() PLIB_PORTS_PinSet(PORTS_ID_0, PORT_CHANNEL_G, PORTS_BIT_POS_8)
#define SS1Off() PLIB_PORTS_PinClear(PORTS_ID_0, PORT_CHANNEL_G, PORTS_BIT_POS_8)
#define SS1StateGet() PLIB_PORTS_PinGetLatched(PORTS_ID_0, PORT_CHANNEL_G, PORTS_BIT_POS_8)
#define SS1StateSet(Value) PLIB_PORTS_PinWrite(PORTS_ID_0, PORT_CHANNEL_G, PORTS_BIT_POS_8, Value)

/*** Functions for SCK1 pin ***/
#define SCK1Toggle() PLIB_PORTS_PinToggle(PORTS_ID_0, PORT_CHANNEL_G, PORTS_BIT_POS_9)
#define SCK1On() PLIB_PORTS_PinSet(PORTS_ID_0, PORT_CHANNEL_G, PORTS_BIT_POS_9)
#define SCK1Off() PLIB_PORTS_PinClear(PORTS_ID_0, PORT_CHANNEL_G, PORTS_BIT_POS_9)
#define SCK1StateGet() PLIB_PORTS_PinGetLatched(PORTS_ID_0, PORT_CHANNEL_G, PORTS_BIT_POS_9)
#define SCK1StateSet(Value) PLIB_PORTS_PinWrite(PORTS_ID_0, PORT_CHANNEL_G, PORTS_BIT_POS_9, Value)

/*** Functions for Supp3 pin ***/
#define Supp3Toggle() PLIB_PORTS_PinToggle(PORTS_ID_0, PORT_CHANNEL_D, PORTS_BIT_POS_8)
#define Supp3On() PLIB_PORTS_PinSet(PORTS_ID_0, PORT_CHANNEL_D, PORTS_BIT_POS_8)
#define Supp3Off() PLIB_PORTS_PinClear(PORTS_ID_0, PORT_CHANNEL_D, PORTS_BIT_POS_8)
#define Supp3StateGet() PLIB_PORTS_PinGetLatched(PORTS_ID_0, PORT_CHANNEL_D, PORTS_BIT_POS_8)
#define Supp3StateSet(Value) PLIB_PORTS_PinWrite(PORTS_ID_0, PORT_CHANNEL_D, PORTS_BIT_POS_8, Value)

/*** Functions for Supp4 pin ***/
#define Supp4Toggle() PLIB_PORTS_PinToggle(PORTS_ID_0, PORT_CHANNEL_D, PORTS_BIT_POS_9)
#define Supp4On() PLIB_PORTS_PinSet(PORTS_ID_0, PORT_CHANNEL_D, PORTS_BIT_POS_9)
#define Supp4Off() PLIB_PORTS_PinClear(PORTS_ID_0, PORT_CHANNEL_D, PORTS_BIT_POS_9)
#define Supp4StateGet() PLIB_PORTS_PinGetLatched(PORTS_ID_0, PORT_CHANNEL_D, PORTS_BIT_POS_9)
#define Supp4StateSet(Value) PLIB_PORTS_PinWrite(PORTS_ID_0, PORT_CHANNEL_D, PORTS_BIT_POS_9, Value)

/*** Functions for Supp5 pin ***/
#define Supp5Toggle() PLIB_PORTS_PinToggle(PORTS_ID_0, PORT_CHANNEL_D, PORTS_BIT_POS_10)
#define Supp5On() PLIB_PORTS_PinSet(PORTS_ID_0, PORT_CHANNEL_D, PORTS_BIT_POS_10)
#define Supp5Off() PLIB_PORTS_PinClear(PORTS_ID_0, PORT_CHANNEL_D, PORTS_BIT_POS_10)
#define Supp5StateGet() PLIB_PORTS_PinGetLatched(PORTS_ID_0, PORT_CHANNEL_D, PORTS_BIT_POS_10)
#define Supp5StateSet(Value) PLIB_PORTS_PinWrite(PORTS_ID_0, PORT_CHANNEL_D, PORTS_BIT_POS_10, Value)

/*** Functions for Supp6 pin ***/
#define Supp6Toggle() PLIB_PORTS_PinToggle(PORTS_ID_0, PORT_CHANNEL_D, PORTS_BIT_POS_11)
#define Supp6On() PLIB_PORTS_PinSet(PORTS_ID_0, PORT_CHANNEL_D, PORTS_BIT_POS_11)
#define Supp6Off() PLIB_PORTS_PinClear(PORTS_ID_0, PORT_CHANNEL_D, PORTS_BIT_POS_11)
#define Supp6StateGet() PLIB_PORTS_PinGetLatched(PORTS_ID_0, PORT_CHANNEL_D, PORTS_BIT_POS_11)
#define Supp6StateSet(Value) PLIB_PORTS_PinWrite(PORTS_ID_0, PORT_CHANNEL_D, PORTS_BIT_POS_11, Value)

/*** Functions for Supp0 pin ***/
#define Supp0Toggle() PLIB_PORTS_PinToggle(PORTS_ID_0, PORT_CHANNEL_D, PORTS_BIT_POS_0)
#define Supp0On() PLIB_PORTS_PinSet(PORTS_ID_0, PORT_CHANNEL_D, PORTS_BIT_POS_0)
#define Supp0Off() PLIB_PORTS_PinClear(PORTS_ID_0, PORT_CHANNEL_D, PORTS_BIT_POS_0)
#define Supp0StateGet() PLIB_PORTS_PinGetLatched(PORTS_ID_0, PORT_CHANNEL_D, PORTS_BIT_POS_0)
#define Supp0StateSet(Value) PLIB_PORTS_PinWrite(PORTS_ID_0, PORT_CHANNEL_D, PORTS_BIT_POS_0, Value)

/*** Functions for Supp1 pin ***/
#define Supp1Toggle() PLIB_PORTS_PinToggle(PORTS_ID_0, PORT_CHANNEL_D, PORTS_BIT_POS_4)
#define Supp1On() PLIB_PORTS_PinSet(PORTS_ID_0, PORT_CHANNEL_D, PORTS_BIT_POS_4)
#define Supp1Off() PLIB_PORTS_PinClear(PORTS_ID_0, PORT_CHANNEL_D, PORTS_BIT_POS_4)
#define Supp1StateGet() PLIB_PORTS_PinGetLatched(PORTS_ID_0, PORT_CHANNEL_D, PORTS_BIT_POS_4)
#define Supp1StateSet(Value) PLIB_PORTS_PinWrite(PORTS_ID_0, PORT_CHANNEL_D, PORTS_BIT_POS_4, Value)

/*** Functions for Supp2 pin ***/
#define Supp2Toggle() PLIB_PORTS_PinToggle(PORTS_ID_0, PORT_CHANNEL_D, PORTS_BIT_POS_5)
#define Supp2On() PLIB_PORTS_PinSet(PORTS_ID_0, PORT_CHANNEL_D, PORTS_BIT_POS_5)
#define Supp2Off() PLIB_PORTS_PinClear(PORTS_ID_0, PORT_CHANNEL_D, PORTS_BIT_POS_5)
#define Supp2StateGet() PLIB_PORTS_PinGetLatched(PORTS_ID_0, PORT_CHANNEL_D, PORTS_BIT_POS_5)
#define Supp2StateSet(Value) PLIB_PORTS_PinWrite(PORTS_ID_0, PORT_CHANNEL_D, PORTS_BIT_POS_5, Value)

/*** Functions for Supp7 pin ***/
#define Supp7Toggle() PLIB_PORTS_PinToggle(PORTS_ID_0, PORT_CHANNEL_D, PORTS_BIT_POS_6)
#define Supp7On() PLIB_PORTS_PinSet(PORTS_ID_0, PORT_CHANNEL_D, PORTS_BIT_POS_6)
#define Supp7Off() PLIB_PORTS_PinClear(PORTS_ID_0, PORT_CHANNEL_D, PORTS_BIT_POS_6)
#define Supp7StateGet() PLIB_PORTS_PinGetLatched(PORTS_ID_0, PORT_CHANNEL_D, PORTS_BIT_POS_6)
#define Supp7StateSet(Value) PLIB_PORTS_PinWrite(PORTS_ID_0, PORT_CHANNEL_D, PORTS_BIT_POS_6, Value)

/*** Functions for LED0 pin ***/
#define LED0Toggle() PLIB_PORTS_PinToggle(PORTS_ID_0, PORT_CHANNEL_E, PORTS_BIT_POS_0)
#define LED0On() PLIB_PORTS_PinSet(PORTS_ID_0, PORT_CHANNEL_E, PORTS_BIT_POS_0)
#define LED0Off() PLIB_PORTS_PinClear(PORTS_ID_0, PORT_CHANNEL_E, PORTS_BIT_POS_0)
#define LED0StateGet() PLIB_PORTS_PinGetLatched(PORTS_ID_0, PORT_CHANNEL_E, PORTS_BIT_POS_0)
#define LED0StateSet(Value) PLIB_PORTS_PinWrite(PORTS_ID_0, PORT_CHANNEL_E, PORTS_BIT_POS_0, Value)

/*** Functions for LED1 pin ***/
#define LED1Toggle() PLIB_PORTS_PinToggle(PORTS_ID_0, PORT_CHANNEL_E, PORTS_BIT_POS_1)
#define LED1On() PLIB_PORTS_PinSet(PORTS_ID_0, PORT_CHANNEL_E, PORTS_BIT_POS_1)
#define LED1Off() PLIB_PORTS_PinClear(PORTS_ID_0, PORT_CHANNEL_E, PORTS_BIT_POS_1)
#define LED1StateGet() PLIB_PORTS_PinGetLatched(PORTS_ID_0, PORT_CHANNEL_E, PORTS_BIT_POS_1)
#define LED1StateSet(Value) PLIB_PORTS_PinWrite(PORTS_ID_0, PORT_CHANNEL_E, PORTS_BIT_POS_1, Value)

/*** Functions for LED2 pin ***/
#define LED2Toggle() PLIB_PORTS_PinToggle(PORTS_ID_0, PORT_CHANNEL_E, PORTS_BIT_POS_2)
#define LED2On() PLIB_PORTS_PinSet(PORTS_ID_0, PORT_CHANNEL_E, PORTS_BIT_POS_2)
#define LED2Off() PLIB_PORTS_PinClear(PORTS_ID_0, PORT_CHANNEL_E, PORTS_BIT_POS_2)
#define LED2StateGet() PLIB_PORTS_PinGetLatched(PORTS_ID_0, PORT_CHANNEL_E, PORTS_BIT_POS_2)
#define LED2StateSet(Value) PLIB_PORTS_PinWrite(PORTS_ID_0, PORT_CHANNEL_E, PORTS_BIT_POS_2, Value)

/*** Functions for LED3 pin ***/
#define LED3Toggle() PLIB_PORTS_PinToggle(PORTS_ID_0, PORT_CHANNEL_E, PORTS_BIT_POS_3)
#define LED3On() PLIB_PORTS_PinSet(PORTS_ID_0, PORT_CHANNEL_E, PORTS_BIT_POS_3)
#define LED3Off() PLIB_PORTS_PinClear(PORTS_ID_0, PORT_CHANNEL_E, PORTS_BIT_POS_3)
#define LED3StateGet() PLIB_PORTS_PinGetLatched(PORTS_ID_0, PORT_CHANNEL_E, PORTS_BIT_POS_3)
#define LED3StateSet(Value) PLIB_PORTS_PinWrite(PORTS_ID_0, PORT_CHANNEL_E, PORTS_BIT_POS_3, Value)

/*** Functions for LED4 pin ***/
#define LED4Toggle() PLIB_PORTS_PinToggle(PORTS_ID_0, PORT_CHANNEL_E, PORTS_BIT_POS_4)
#define LED4On() PLIB_PORTS_PinSet(PORTS_ID_0, PORT_CHANNEL_E, PORTS_BIT_POS_4)
#define LED4Off() PLIB_PORTS_PinClear(PORTS_ID_0, PORT_CHANNEL_E, PORTS_BIT_POS_4)
#define LED4StateGet() PLIB_PORTS_PinGetLatched(PORTS_ID_0, PORT_CHANNEL_E, PORTS_BIT_POS_4)
#define LED4StateSet(Value) PLIB_PORTS_PinWrite(PORTS_ID_0, PORT_CHANNEL_E, PORTS_BIT_POS_4, Value)


/*** Application Instance 0 Configuration ***/

//DOM-IGNORE-BEGIN
#ifdef __cplusplus
}
#endif
//DOM-IGNORE-END

#endif // _SYSTEM_CONFIG_H
/*******************************************************************************
 End of File
*/
